yusendesu/gowin_fpga_inverted_pendulum/GoWin/figures/fig_2_4.png

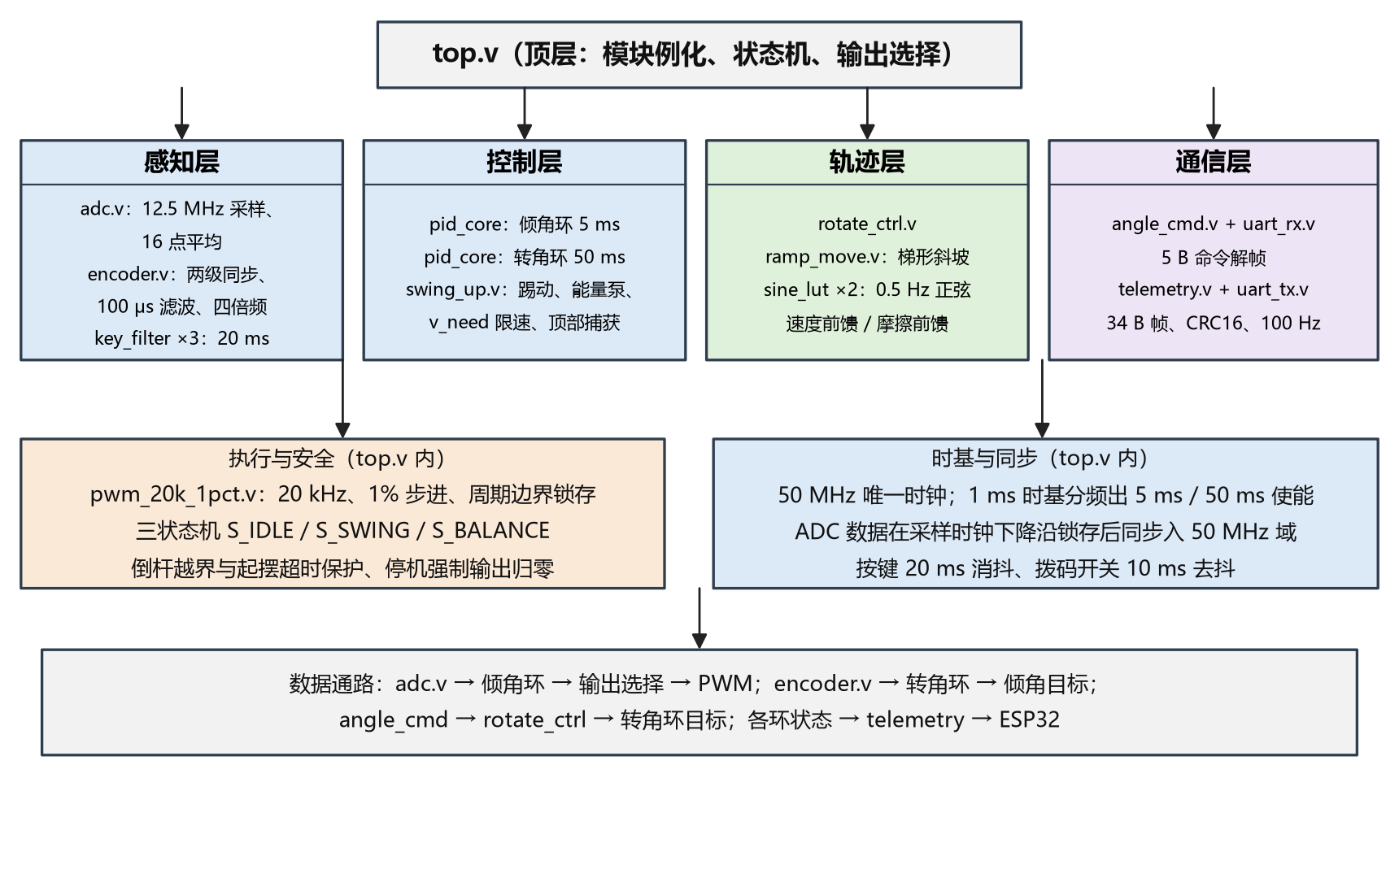
GoWin/figures/fig_2_4.png
