yusendesu/gowin_fpga_inverted_pendulum/GoWin/figures/fig_2_7.png

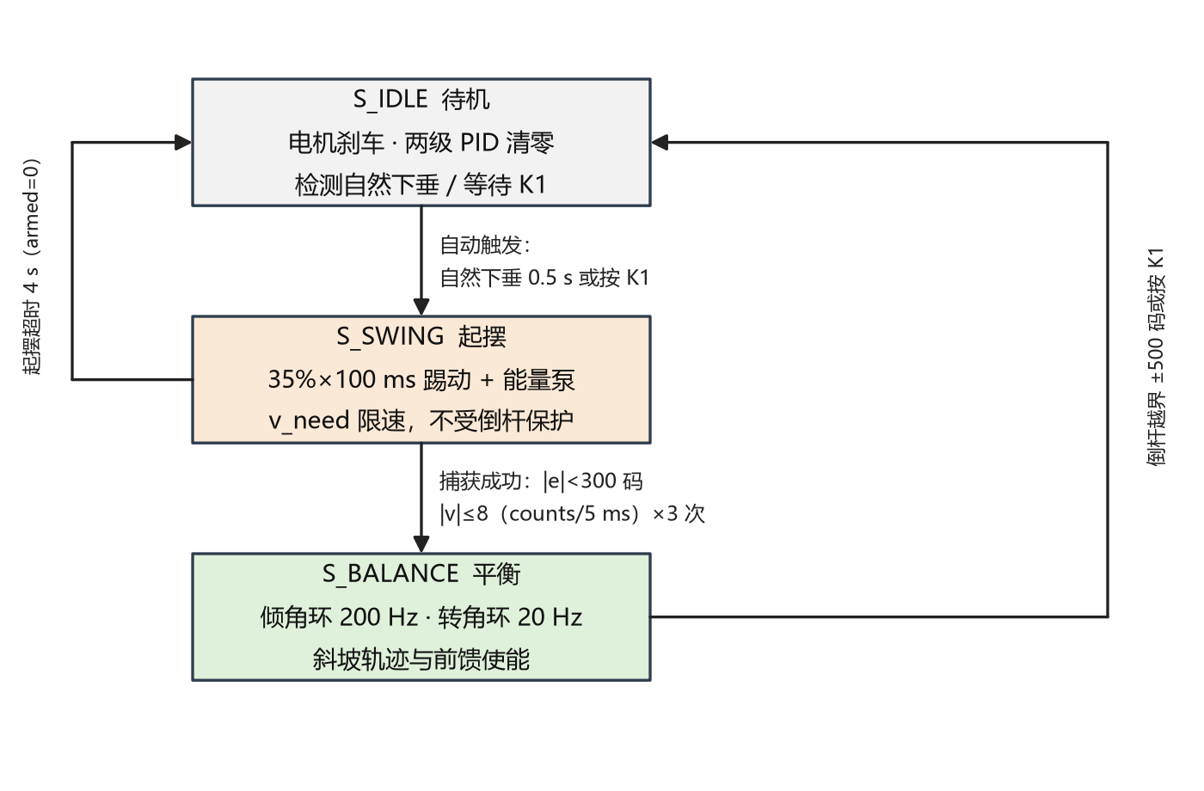
GoWin/figures/fig_2_7.png
