yusendesu/gowin_fpga_inverted_pendulum/GoWin/figures/hardware.png

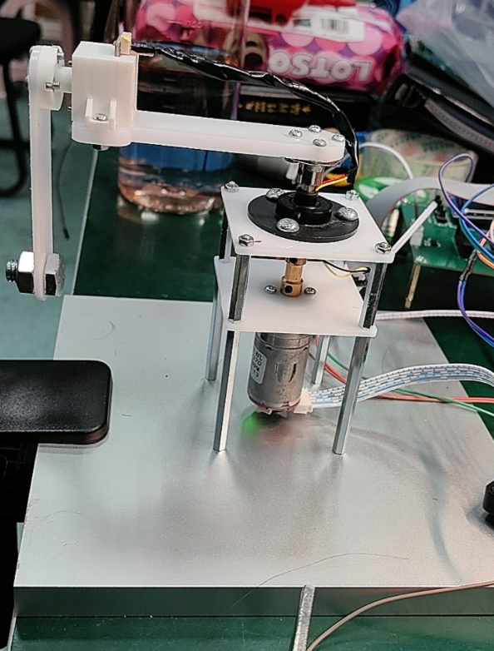
GoWin/figures/hardware.png
