yusendesu/gowin_fpga_inverted_pendulum/GoWin/figures/ui_gauge.png

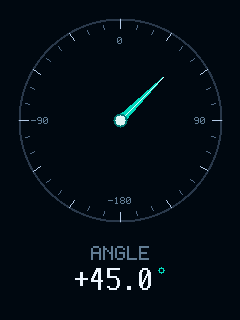
GoWin/figures/ui_gauge.png
