yusendesu/gowin_fpga_inverted_pendulum/GoWin/figures/ui_setting.png

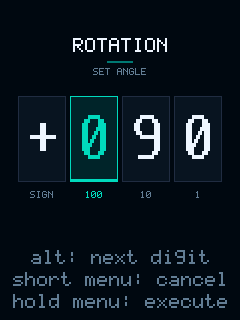
GoWin/figures/ui_setting.png
