yusendesu/gowin_fpga_inverted_pendulum/GoWin/sim/swing/model.png

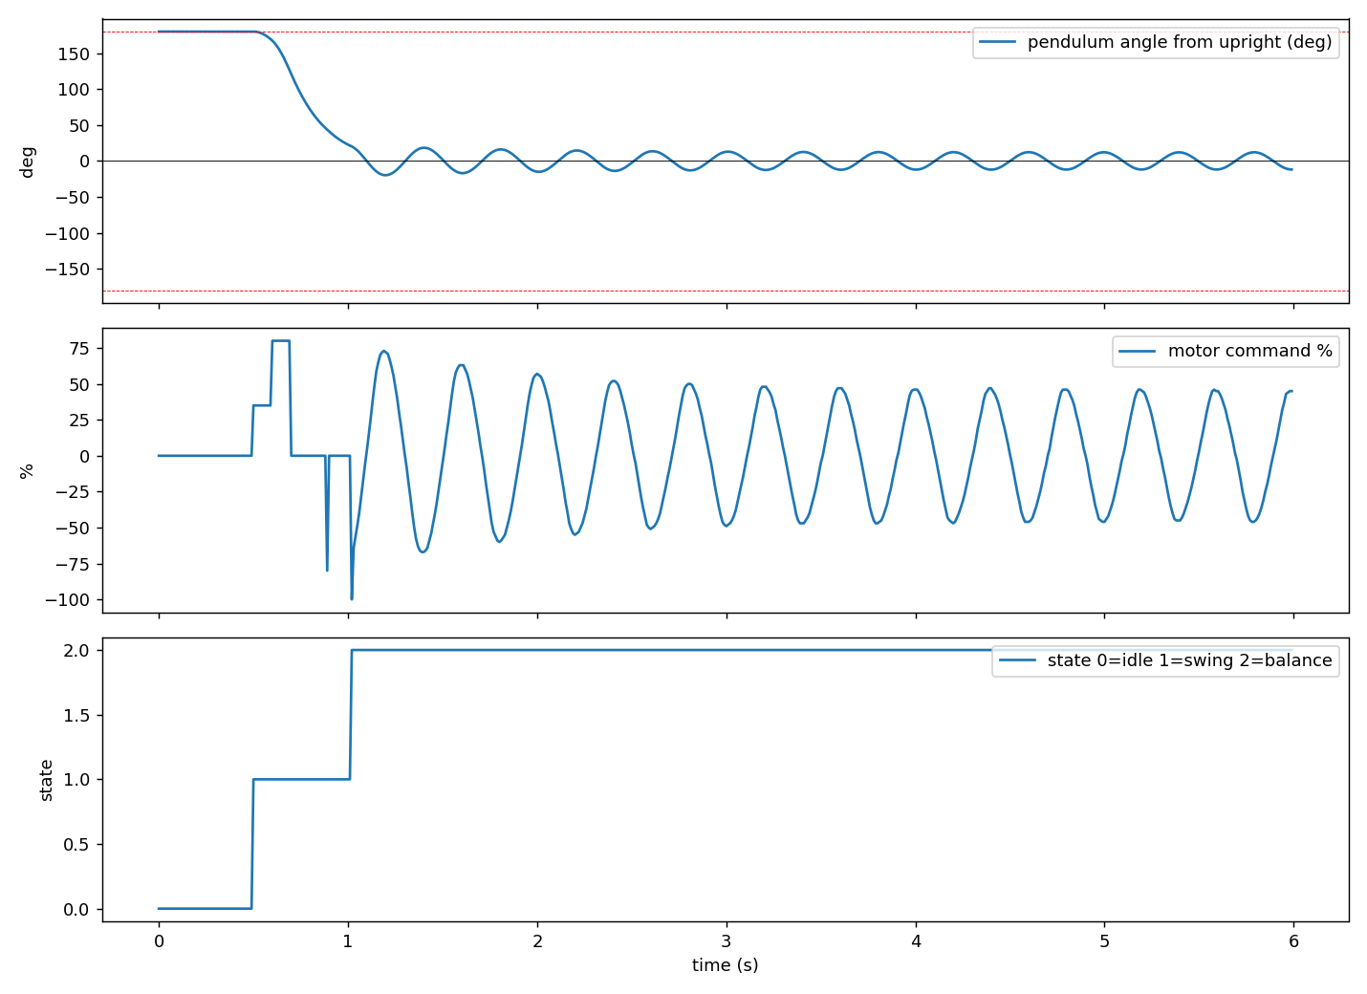
GoWin/sim/swing/model.png
