yusendesu/gowin_fpga_inverted_pendulum/GoWin/sim/swing/run_analysis.png

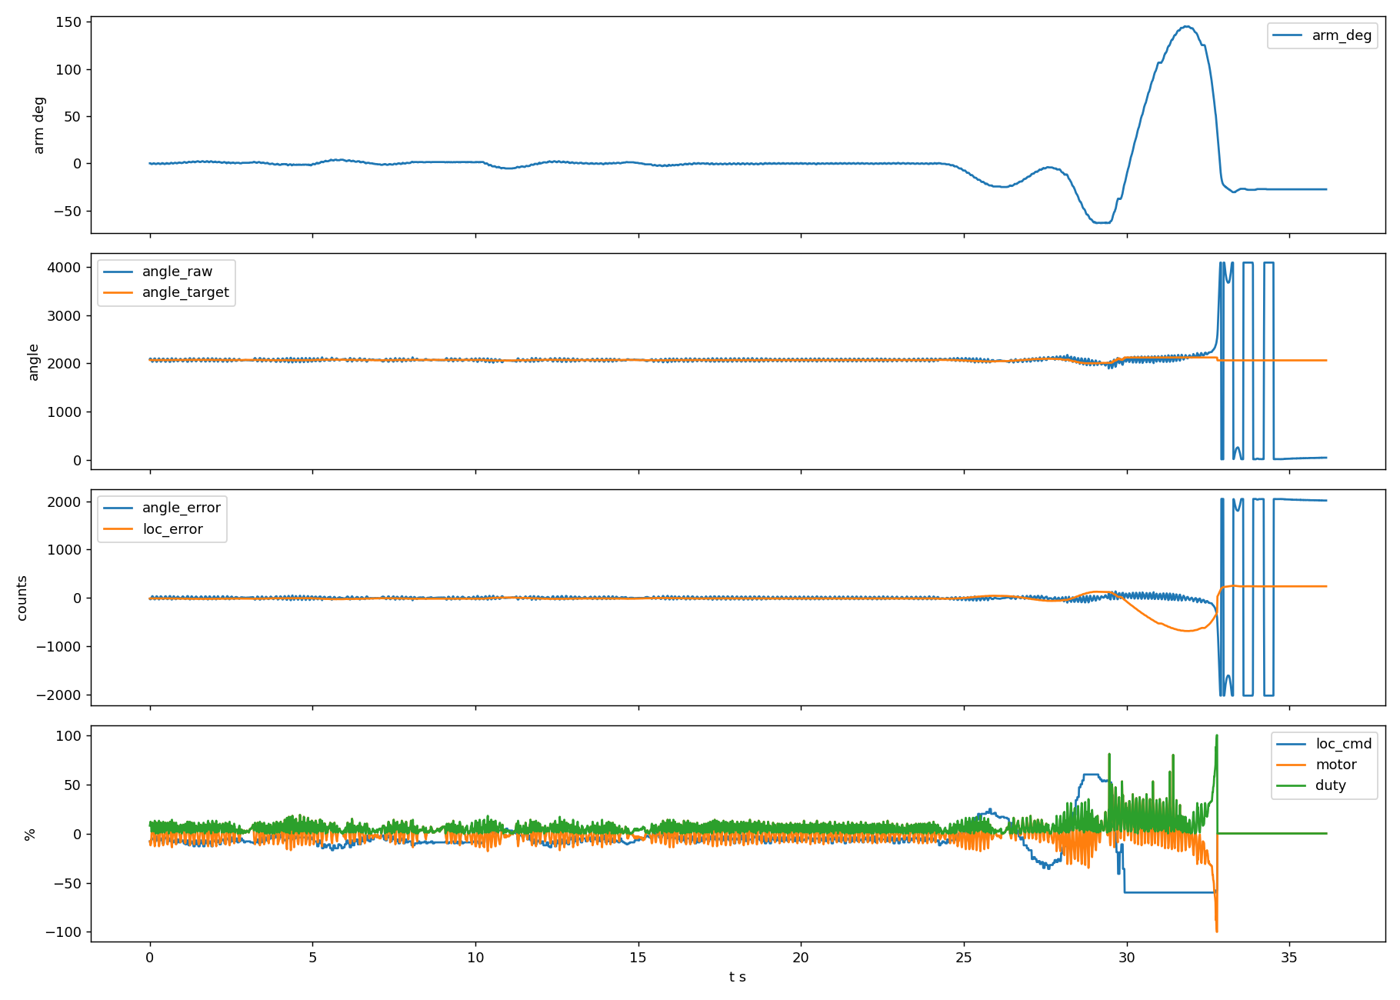
GoWin/sim/swing/run_analysis.png
