yusendesu/gowin_fpga_inverted_pendulum/v1_basic/key_filter_sim.jpg

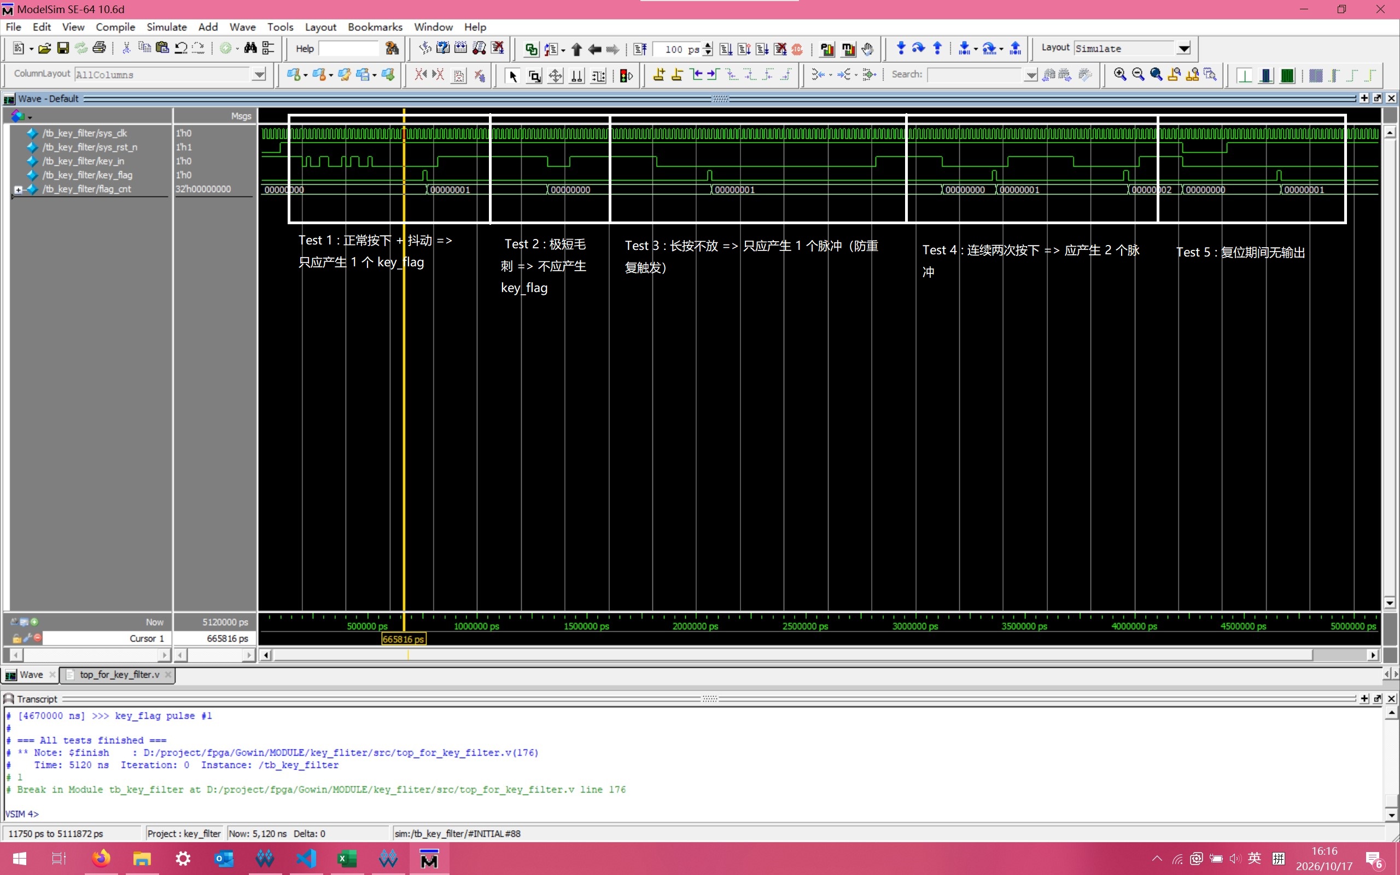
v1_basic/key_filter_sim.jpg
