yusendesu/gowin_fpga_inverted_pendulum/GoWin/src/sine_lut.v

// 256-entry sine LUT, sin(2*pi*i/256), Q15 signed
module sine_lut (
    input  wire [7:0] idx,
    output reg signed [15:0] val
);
    always @* begin
        case (idx)
        8'd0: val = 16'sd0;
        8'd1: val = 16'sd804;
        8'd2: val = 16'sd1608;
        8'd3: val = 16'sd2410;
        8'd4: val = 16'sd3212;
        8'd5: val = 16'sd4011;
        8'd6: val = 16'sd4808;
        8'd7: val = 16'sd5602;
        8'd8: val = 16'sd6393;
        8'd9: val = 16'sd7179;
        8'd10: val = 16'sd7962;
        8'd11: val = 16'sd8739;
        8'd12: val = 16'sd9512;
        8'd13: val = 16'sd10278;
        8'd14: val = 16'sd11039;
        8'd15: val = 16'sd11793;
        8'd16: val = 16'sd12539;
        8'd17: val = 16'sd13279;
        8'd18: val = 16'sd14010;
        8'd19: val = 16'sd14732;
        8'd20: val = 16'sd15446;
        8'd21: val = 16'sd16151;
        8'd22: val = 16'sd16846;
        8'd23: val = 16'sd17530;
        8'd24: val = 16'sd18204;
        8'd25: val = 16'sd18868;
        8'd26: val = 16'sd19519;
        8'd27: val = 16'sd20159;
        8'd28: val = 16'sd20787;
        8'd29: val = 16'sd21403;
        8'd30: val = 16'sd22005;
        8'd31: val = 16'sd22594;
        8'd32: val = 16'sd23170;
        8'd33: val = 16'sd23731;
        8'd34: val = 16'sd24279;
        8'd35: val = 16'sd24811;
        8'd36: val = 16'sd25329;
        8'd37: val = 16'sd25832;
        8'd38: val = 16'sd26319;
        8'd39: val = 16'sd26790;
        8'd40: val = 16'sd27245;
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
        8'd249: val = -16'sd5602;
        8'd250: val = -16'sd4808;
        8'd251: val = -16'sd4011;
        8'd252: val = -16'sd3212;
        8'd253: val = -16'sd2410;
        8'd254: val = -16'sd1608;
        8'd255: val = -16'sd804;
        endcase
    end
endmodule
