yusendesu/gowin_fpga_inverted_pendulum/exp32/vga1_16x32.py

WIDTH = 16
HEIGHT = 32
FIRST = 0x20
LAST = 0x7f
_FONT = \
b'\x00\x00\x00\x00\x00\x00\x00\x00\x00\x00\x00\x00\x00\x00\x00\x00\x00\x00\x00\x00\x00\x00\x00\x00\x00\x00\x00\x00\x00\x00\x00\x00\x00\x00\x00\x00\x00\x00\x00\x00\x00\x00\x00\x00\x00\x00\x00\x00\x00\x00\x00\x00\x00\x00\x00\x00\x00\x00\x00\x00\x00\x00\x00\x00'\
b'\x00\x00\x00\x00\x00\x00\x00\x00\x01\xc0\x01\xc0\x01\xc0\x01\xc0\x01\xc0\x01\xc0\x01\xc0\x01\xc0\x01\xc0\x01\xc0\x01\xc0\x01\xc0\x01\xc0\x01\xc0\x01\xc0\x01\xc0\x00\x00\x00\x00\x01\xc0\x01\xc0\x01\xc0\x01\xc0\x00\x00\x00\x00\x00\x00\x00\x00\x00\x00\x00\x00'\
b'\x00\x00\x00\x00\x1c\x38\x1c\x38\x1c\x38\x1c\x38\x1c\x38\x1c\x38\x1c\x38\x1c\x38\x00\x00\x00\x00\x00\x00\x00\x00\x00\x00\x00\x00\x00\x00\x00\x00\x00\x00\x00\x00\x00\x00\x00\x00\x00\x00\x00\x00\x00\x00\x00\x00\x00\x00\x00\x00\x00\x00\x00\x00\x00\x00\x00\x00'\
b'\x00\x00\x00\x00\x00\x00\x00\x00\x00\x00\x00\x00\x1c\x38\x1c\x38\x1c\x38\x1c\x38\x7f\xfe\x7f\xfe\x1c\x38\x1c\x38\x1c\x38\x1c\x38\x1c\x38\x1c\x38\x1c\x38\x1c\x38\x7f\xfe\x7f\xfe\x1c\x38\x1c\x38\x1c\x38\x1c\x38\x00\x00\x00\x00\x00\x00\x00\x00\x00\x00\x00\x00'\
b'\x00\x00\x00\x00\x01\x80\x01\x80\x0f\xf0\x0f\xf0\x39\x9c\x39\x9c\x71\x8e\x71\x8e\x71\x80\x71\x80\x39\x80\x39\x80\x0f\xf0\x0f\xf0\x01\x9c\x01\x9c\x01\x8e\x01\x8e\x71\x8e\x71\x8e\x39\x9c\x39\x9c\x0f\xf0\x0f\xf0\x01\x80\x01\x80\x00\x00\x00\x00\x00\x00\x00\x00'\
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
b'\x00\x00\x00\x00\x00\x00\x00\x00\x00\x00\x00\x00\x00\x00\x00\x00\x00\x00\x00\x00\x00\x00\x00\x00\x38\x0e\x38\x0e\x38\x0e\x38\x0e\x38\x0e\x38\x0e\x39\xce\x39\xce\x3b\xee\x3b\xee\x1f\x7c\x1f\x7c\x0e\x38\x0e\x38\x00\x00\x00\x00\x00\x00\x00\x00\x00\x00\x00\x00'\
b'\x00\x00\x00\x00\x00\x00\x00\x00\x00\x00\x00\x00\x00\x00\x00\x00\x00\x00\x00\x00\x00\x00\x00\x00\x1c\x38\x1c\x38\x0e\x70\x0e\x70\x07\xe0\x07\xe0\x03\xc0\x03\xc0\x07\xe0\x07\xe0\x0e\x70\x0e\x70\x1c\x38\x1c\x38\x00\x00\x00\x00\x00\x00\x00\x00\x00\x00\x00\x00'\
b'\x00\x00\x00\x00\x00\x00\x00\x00\x00\x00\x00\x00\x00\x00\x00\x00\x00\x00\x00\x00\x00\x00\x00\x00\x38\x0e\x38\x0e\x1c\x1c\x1c\x1c\x0e\x38\x0e\x38\x07\x70\x07\x70\x03\xe0\x03\xe0\x01\xc0\x01\xc0\x03\x80\x03\x80\x07\x00\x07\x00\x0e\x00\x0e\x00\x00\x00\x00\x00'\
b'\x00\x00\x00\x00\x00\x00\x00\x00\x00\x00\x00\x00\x00\x00\x00\x00\x00\x00\x00\x00\x00\x00\x00\x00\x3f\xfe\x3f\xfe\x00\x1c\x00\x1c\x00\x70\x00\x70\x01\xc0\x01\xc0\x07\x00\x07\x00\x1c\x00\x1c\x00\x3f\xfe\x3f\xfe\x00\x00\x00\x00\x00\x00\x00\x00\x00\x00\x00\x00'\
b'\x00\x00\x00\x00\x00\x00\x00\x00\x00\xf8\x00\xf8\x01\xc0\x01\xc0\x03\x80\x03\x80\x03\x80\x03\x80\x03\x80\x03\x80\x1e\x00\x1e\x00\x03\x80\x03\x80\x03\x80\x03\x80\x03\x80\x03\x80\x01\xc0\x01\xc0\x00\xf8\x00\xf8\x00\x00\x00\x00\x00\x00\x00\x00\x00\x00\x00\x00'\
b'\x00\x00\x00\x00\x00\x00\x00\x00\x01\xc0\x01\xc0\x01\xc0\x01\xc0\x01\xc0\x01\xc0\x01\xc0\x01\xc0\x01\xc0\x01\xc0\x00\x00\x00\x00\x01\xc0\x01\xc0\x01\xc0\x01\xc0\x01\xc0\x01\xc0\x01\xc0\x01\xc0\x01\xc0\x01\xc0\x00\x00\x00\x00\x00\x00\x00\x00\x00\x00\x00\x00'\
b'\x00\x00\x00\x00\x00\x00\x00\x00\x1f\x00\x1f\x00\x03\x80\x03\x80\x01\xc0\x01\xc0\x01\xc0\x01\xc0\x01\xc0\x01\xc0\x00\x78\x00\x78\x01\xc0\x01\xc0\x01\xc0\x01\xc0\x01\xc0\x01\xc0\x03\x80\x03\x80\x1f\x00\x1f\x00\x00\x00\x00\x00\x00\x00\x00\x00\x00\x00\x00\x00'\
b'\x00\x00\x00\x00\x00\x00\x00\x00\x07\x9e\x07\x9e\x3c\xf0\x3c\xf0\x00\x00\x00\x00\x00\x00\x00\x00\x00\x00\x00\x00\x00\x00\x00\x00\x00\x00\x00\x00\x00\x00\x00\x00\x00\x00\x00\x00\x00\x00\x00\x00\x00\x00\x00\x00\x00\x00\x00\x00\x00\x00\x00\x00\x00\x00\x00\x00'\
b'\x00\x00\x00\x00\x00\x00\x00\x00\x00\x00\x00\x00\x00\x00\x00\x00\x01\xc0\x01\xc0\x07\x70\x07\x70\x1c\x1c\x1c\x1c\x70\x07\x70\x07\x70\x07\x70\x07\x7f\xff\x7f\xff\x00\x00\x00\x00\x00\x00\x00\x00\x00\x00\x00\x00\x00\x00\x00\x00\x00\x00\x00\x00\x00\x00\x00\x00'\
 
FONT = memoryview(_FONT)
 
 
