yusendesu/gowin_fpga_inverted_pendulum/GoWin/src/uart_tx.v

module  uart_tx #(

    parameter   UART_BPS    =   'd9600,			//串口波特率
    parameter   CLK_FREQ    =   'd50_000_000	//时钟频率
	
) (

     input   	            sys_clk     ,	//系统时钟50MHz
     input   	            sys_rst_n   ,	//全局复位
	 
     input			[7:0]	pi_data     ,	//模块输入的8bit数据
     input					pi_flag     ,	//并行数据有效标志信号
 
     output		reg			tx			,	//串转并后的1bit数据
     output		reg	            pi_done			//发送完成一个字节标志（停止位结束）
	 
);

localparam  BAUD_CNT_MAX    =   CLK_FREQ/UART_BPS   ;

//reg   define
reg [12:0]  baud_cnt;
reg         bit_flag;
reg [3:0]   bit_cnt ;
reg         work_en ;


//work_en:接收数据工作使能信号
always@(posedge sys_clk or negedge sys_rst_n)
        if(sys_rst_n == 1'b0)
            work_en <= 1'b0;
        else    if(pi_flag == 1'b1)
            work_en <= 1'b1;
        else    if((bit_flag == 1'b1) && (bit_cnt == 4'd9))
            work_en <= 1'b0;

//baud_cnt:波特率计数器计数，从0计数到BAUD_CNT_MAX - 1
always@(posedge sys_clk or negedge sys_rst_n)
        if(sys_rst_n == 1'b0)
            baud_cnt <= 13'b0;
        else    if((baud_cnt == BAUD_CNT_MAX - 1) || (work_en == 1'b0))
            baud_cnt <= 13'b0;
        else    if(work_en == 1'b1)
            baud_cnt <= baud_cnt + 1'b1;

//bit_flag:当baud_cnt计数器计数到1时让bit_flag拉高一个时钟的高电平
always@(posedge sys_clk or negedge sys_rst_n)
        if(sys_rst_n == 1'b0)
            bit_flag <= 1'b0;
        else    if(baud_cnt == 13'd1)
            bit_flag <= 1'b1;
        else
            bit_flag <= 1'b0;

//bit_cnt:数据位数个数计数，10个有效数据（含起始位和停止位）到来后计数器清零
always@(posedge sys_clk or negedge sys_rst_n)
    if(sys_rst_n == 1'b0)
        bit_cnt <= 4'b0;
    else    if((bit_flag == 1'b1) && (bit_cnt == 4'd9))
        bit_cnt <= 4'b0;
    else    if((bit_flag == 1'b1) && (work_en == 1'b1))
        bit_cnt <= bit_cnt + 1'b1;

//tx:输出数据在满足rs232协议（起始位为0，停止位为1）的情况下一位一位输出
always@(posedge sys_clk or negedge sys_rst_n)
        if(sys_rst_n == 1'b0)
            tx <= 1'b1; //空闲状态时为高电平
        else    if(bit_flag == 1'b1)
            case(bit_cnt)
                0       : tx <= 1'b0;
                1       : tx <= pi_data[0];
                2       : tx <= pi_data[1];
                3       : tx <= pi_data[2];
                4       : tx <= pi_data[3];
                5       : tx <= pi_data[4];
                6       : tx <= pi_data[5];
                7       : tx <= pi_data[6];
                8       : tx <= pi_data[7];
                9       : tx <= 1'b1;
                default : tx <= 1'b1;
            endcase


reg         work_en_r1 ;
reg         work_en_r2 ;
always@(posedge sys_clk or negedge sys_rst_n)
        if(sys_rst_n == 1'b0)begin  
            work_en_r1 <= 1'b0;
            work_en_r2 <= 1'b0;
        end
        else begin
            work_en_r1 <= work_en;
            work_en_r2 <= work_en_r1;
        end

// pi_done: work_en 下降沿只代表“停止位开始”，必须再等一个完整位周期，
// 否则背靠背连发时停止位会被下一字节的起始位截短，接收端会把停止位
// 当成 bit7（0x55 被读成 0x95）。
reg         stop_wait;
reg  [12:0] stop_cnt;
always@(posedge sys_clk or negedge sys_rst_n)
        if(sys_rst_n == 1'b0)begin
            stop_wait <= 1'b0;
            stop_cnt  <= 13'd0;
            pi_done   <= 1'b0;
        end
        else begin
            pi_done <= 1'b0;
            if((work_en_r1 == 1'b0) && (work_en_r2 == 1'b1))begin
                stop_wait <= 1'b1;
                stop_cnt  <= 13'd0;
            end
            else if(stop_wait == 1'b1)begin
                if(stop_cnt == BAUD_CNT_MAX - 1)begin
                    stop_wait <= 1'b0;
                    pi_done   <= 1'b1;
                end
                else begin
                    stop_cnt <= stop_cnt + 1'b1;
                end
            end
        end

endmodule
