yusendesu/gowin_fpga_inverted_pendulum/GoWin/tools/build_report.py

# -*- coding: utf-8 -*-
"""按实际工程重建技术文档（保留原 docx 的样式、页面设置与页脚）。"""
import copy
import os
import re
import sys

from docx import Document
from docx.enum.table import WD_TABLE_ALIGNMENT
from docx.enum.text import WD_ALIGN_PARAGRAPH, WD_BREAK
from docx.oxml import OxmlElement
from docx.oxml.ns import qn
from docx.shared import Cm, Pt, RGBColor

HERE = os.path.dirname(os.path.abspath(__file__))
ROOT = os.path.dirname(HERE)
FIG = os.path.join(ROOT, "figures")

SRC = os.path.join(ROOT, "技术文档_底稿_基于FPGA的实时倒立摆姿态控制系统.docx")
DST = os.path.join(ROOT, "技术文档_基于FPGA的一阶旋转倒立摆实时姿态控制系统.docx")


# ---------------------------------------------------------------------------
# 基础排版工具
# ---------------------------------------------------------------------------

def clear_body(doc):
    body = doc.element.body
    for child in list(body):
        if child.tag == qn("w:sectPr"):
            continue
        body.remove(child)


def _set_run_font(run, size=None, bold=None, superscript=False):
    if size is not None:
        run.font.size = Pt(size)
    if bold is not None:
        run.font.bold = bold
    if superscript:
        run.font.superscript = True
    # 中英文分别指定，避免混排时回退到 Calibri
    rpr = run._element.get_or_add_rPr()
    rfonts = rpr.find(qn("w:rFonts"))
    if rfonts is None:
        rfonts = OxmlElement("w:rFonts")
        rpr.append(rfonts)
    rfonts.set(qn("w:ascii"), "Times New Roman")
    rfonts.set(qn("w:hAnsi"), "Times New Roman")
    rfonts.set(qn("w:eastAsia"), "宋体")


CITE_RE = re.compile(r"\[\[(\d+(?:,\s*\d+)*)\]\]")


def para(doc, text, style="Normal", align=None, size=None, bold=False,
         before=None, after=None, indent_chars=None, line=None, keep_next=False):
    p = doc.add_paragraph(style=style)
    if align is not None:
        p.alignment = align
    pf = p.paragraph_format
    if before is not None:
        pf.space_before = Pt(before)
    if after is not None:
        pf.space_after = Pt(after)
    if line is not None:
        pf.line_spacing = line
    if indent_chars:
        pf.first_line_indent = Pt(indent_chars * (size or 12))

    pos = 0
    for m in CITE_RE.finditer(text):
        head = text[pos:m.start()]
        if head:
            _set_run_font(p.add_run(head), size, bold)
        _set_run_font(p.add_run("[%s]" % m.group(1)), size, bold, superscript=True)
        pos = m.end()
    tail = text[pos:]
    if tail:
        _set_run_font(p.add_run(tail), size, bold)
    if keep_next:
        pf.keep_with_next = True
    return p


def h1(doc, text):
    p = doc.add_paragraph(style="Heading 1")
    _set_run_font(p.add_run(text), 14, True)
    return p


def h2(doc, text):
    p = doc.add_paragraph(style="Heading 2")
    _set_run_font(p.add_run(text), 12, True)
    return p


def h3(doc, text):
    p = doc.add_paragraph(style="Heading 3")
    _set_run_font(p.add_run(text), 12, True)
    return p


def caption(doc, text):
    p = doc.add_paragraph(style="Normal")
    p.alignment = WD_ALIGN_PARAGRAPH.CENTER
    p.paragraph_format.space_before = Pt(3)
    p.paragraph_format.space_after = Pt(12)
    p.paragraph_format.line_spacing = 1.0
    _set_run_font(p.add_run(text), 10.5, False)
    return p


def figure(doc, name, width_cm, title):
    p = doc.add_paragraph(style="Normal")
    p.alignment = WD_ALIGN_PARAGRAPH.CENTER
    p.paragraph_format.space_before = Pt(6)
    p.paragraph_format.space_after = Pt(0)
    p.paragraph_format.line_spacing = 1.0
    p.add_run().add_picture(os.path.join(FIG, name), width=Cm(width_cm))
    caption(doc, title)


def figure_pair(doc, names, width_cm, title):
    p = doc.add_paragraph(style="Normal")
    p.alignment = WD_ALIGN_PARAGRAPH.CENTER
    p.paragraph_format.space_before = Pt(6)
    p.paragraph_format.space_after = Pt(0)
    p.paragraph_format.line_spacing = 1.0
    for i, name in enumerate(names):
        if i:
            r = p.add_run("    ")
            _set_run_font(r, 10.5)
        p.add_run().add_picture(os.path.join(FIG, name), width=Cm(width_cm))
    caption(doc, title)


def _shade(cell, hex_color="F2F2F2"):
    tcPr = cell._tc.get_or_add_tcPr()
    shd = OxmlElement("w:shd")
    shd.set(qn("w:val"), "clear")
    shd.set(qn("w:color"), "auto")
    shd.set(qn("w:fill"), hex_color)
    tcPr.append(shd)


def _cell_text(cell, text, bold=False, size=10.5, align=WD_ALIGN_PARAGRAPH.CENTER):
    cell.text = ""
    p = cell.paragraphs[0]
    p.alignment = align
    p.paragraph_format.space_before = Pt(2)
    p.paragraph_format.space_after = Pt(2)
    p.paragraph_format.line_spacing = 1.0
    _set_run_font(p.add_run(text), size, bold)


def table(doc, headers, rows, widths, align_left_cols=(), font=10.5):
    t = doc.add_table(rows=1, cols=len(headers))
    t.style = "Table Grid"
    t.alignment = WD_TABLE_ALIGNMENT.CENTER
    t.autofit = False
    hdr = t.rows[0]
    trPr = hdr._tr.get_or_add_trPr()
    tblHeader = OxmlElement("w:tblHeader")
    trPr.append(tblHeader)
    for i, h in enumerate(headers):
        _cell_text(hdr.cells[i], h, True, font)
        _shade(hdr.cells[i])
        hdr.cells[i].width = Cm(widths[i])
    for row in rows:
        cells = t.add_row().cells
        for i, v in enumerate(row):
            al = WD_ALIGN_PARAGRAPH.LEFT if i in align_left_cols else WD_ALIGN_PARAGRAPH.CENTER
            _cell_text(cells[i], v, False, font, al)
            cells[i].width = Cm(widths[i])
    for i, w in enumerate(widths):
        for row in t.rows:
            row.cells[i].width = Cm(w)

    # 固定列宽：同时写 tblGrid、tblW 与 tblLayout，避免渲染器按内容重排
    total = sum(widths)
    tblPr = t._tbl.tblPr
    for tag in ("w:tblW", "w:tblLayout"):
        el = tblPr.find(qn(tag))
        if el is not None:
            tblPr.remove(el)
    tblW = OxmlElement("w:tblW")
    tblW.set(qn("w:type"), "dxa")
    tblW.set(qn("w:w"), str(int(total * 567)))
    tblPr.append(tblW)
    layout = OxmlElement("w:tblLayout")
    layout.set(qn("w:type"), "fixed")
    tblPr.append(layout)
    grid = t._tbl.tblGrid
    for col, w in zip(grid.gridCol_lst, widths):
        col.w = Cm(w)
    # 行不跨页拆开
    for row in t.rows:
        trPr = row._tr.get_or_add_trPr()
        cant = OxmlElement("w:cantSplit")
        trPr.append(cant)
    doc.add_paragraph(style="Normal").paragraph_format.space_after = Pt(2)
    return t


def log_block(doc, text):
    p = doc.add_paragraph(style="Normal")
    p.paragraph_format.left_indent = Cm(1.0)
    p.paragraph_format.space_before = Pt(3)
    p.paragraph_format.space_after = Pt(8)
    p.paragraph_format.line_spacing = 1.15
    r = p.add_run(text)
    r.font.size = Pt(9.5)
    rpr = r._element.get_or_add_rPr()
    rfonts = OxmlElement("w:rFonts")
    rfonts.set(qn("w:ascii"), "Consolas")
    rfonts.set(qn("w:hAnsi"), "Consolas")
    rfonts.set(qn("w:eastAsia"), "宋体")
    rpr.append(rfonts)
    return p


def page_break(doc):
    p = doc.add_paragraph(style="Normal")
    p.add_run().add_break(WD_BREAK.PAGE)


# ---------------------------------------------------------------------------
# 正文
# ---------------------------------------------------------------------------

def build():
    doc = Document(SRC)
    clear_body(doc)

    cp = doc.core_properties
    cp.title = "基于 FPGA 的一阶旋转倒立摆实时姿态控制系统"
    cp.subject = "项目技术文档"
    cp.author = "项目组"
    cp.last_modified_by = "项目组"
    cp.comments = "依据 Gowin GW2A-18 工程与 ESP32 MicroPython 工程整理"

    # ---------------- 封面标题 ----------------
    p = doc.add_paragraph(style="Normal")
    p.alignment = WD_ALIGN_PARAGRAPH.CENTER
    p.paragraph_format.space_before = Pt(18)
    p.paragraph_format.space_after = Pt(18)
    _set_run_font(p.add_run("基于 FPGA 的一阶旋转倒立摆实时姿态控制系统"), 18, True)

    p = doc.add_paragraph(style="Normal")
    p.alignment = WD_ALIGN_PARAGRAPH.CENTER
    p.paragraph_format.space_after = Pt(24)
    _set_run_font(p.add_run("——能量泵起摆、双速率串级平衡与角度定位的实现"), 12, False)

    # ---------------- 摘要 ----------------
    h2(doc, "摘  要")
    para(doc, (
        "本作品以高云 GW2A-LV18PG256CC8/I7（GW2A-18）FPGA 为唯一实时控制核心，实现了一阶旋转倒立摆"
        "（Furuta 摆）的自动起摆、长期直立与角度定位。整机只有三个外设：一台直流减速电机、一个增量式"
        "编码器和一个模数转换通道。电机经 30∶1 减速器驱动摆臂，编码器与电机尾轴同轴，四倍频后摆臂转一圈"
        "为 1320 个计数，用于测量摆臂转角 φ；摆杆铰接在摆臂末端，铰接轴同轴安装 WDD35D4 导电塑料电位器，"
        "其输出经 AD9200 10 bit 并行 ADC 以 12.5 MHz 采样，在 1 ms 窗口内等间隔抽取 16 点求平均后扩展为"
        "12 bit 倾角码值 θ。"
    ))
    para(doc, (
        "FPGA 片内以纯硬件逻辑实现全部实时回路：倾角内环 5 ms（200 Hz）、摆臂转角外环 50 ms（20 Hz），"
        "两级均采用 16.16 定点 PID；20 kHz、1% 步进的 PWM 由周期计数器在周期边界锁存占空比；采样、运算与"
        "输出同在 50 MHz 时钟域内，由同一组计数器严格分频，控制周期抖动为零个时钟周期，不受中断响应与"
        "任务调度影响。起摆采用“固定踢动—能量泵—v_need 限速—顶部捕获”四段式策略：摆杆自然下垂持续"
        "0.5 s 后自动触发一次起摆，能量泵按能量梯度方向注入机械能，v_need 查表保证摆杆“刚好到顶”而不"
        "越摆越快，进入捕获窗口并连续三个节拍满足角度与角速度条件后，无扰切入平衡控制。定位运动把轨迹"
        "生成与跟踪分离：梯形速度斜坡给出有界、可预测的转角目标，叠加速度前馈与摩擦前馈，并设置总行程、"
        "跟踪误差与移动时间三重保护，使“边走边稳”成为结构性保证而非调参结果；拨码开关还可启动 0.5 Hz、"
        "8° 的往复正弦摆动。"
    ))
    para(doc, (
        "人机交互由 ESP32（MicroPython）承担：240×320 ST7789 屏以指针表盘显示角度，4 个按键完成旋转角的"
        "符号与数值设定，长按即下发；ESP32 同时开启 Wi-Fi 与内置 HTTP 服务，手机连接热点后用网页即可下发"
        "角度，形成“屏 + 键 + 网页”三通道交互。FPGA 以 100 Hz 发送 34 字节遥测帧，带序号、毫秒时间戳与"
        "CRC-16 校验，回传角度、目标、编码器、两环输出、占空比与全部状态位。RTL 仿真表明：起摆 0.575 s "
        "进入捕获窗口，捕获时角度偏差 148 码、角速度 −8 counts/5 ms；+90° 定位在 3.366 s 内完成且无过冲；"
        "解帧、斜坡、PID 抗饱和等 9 组用例全部通过。样机联调完成了自动起摆、稳定直立与角度设定三项功能。"
    ))
    para(doc, (
        "在此基础上，系统把网络控制作为“监督层”引入，形成“实时环在片内、网络环在片外”的分层结构："
        "ESP32 网关向上提供 Wi-Fi 与 HTTP 接口，向下以 5 字节命令与 100 Hz 遥测同 FPGA 交互。网络延迟与"
        "丢包不进入 5 ms 内环，远程指令须经协议限幅、梯形斜坡与倾角限幅三级整形后才作用于机构，因此"
        "断链时装置仍能本地保持平衡。该结构既满足工业现场远程遥操作与集中监控的需要，也为强化学习等"
        "AI 策略预留了数据采集与策略回灌通道，使算法迭代可以在不影响装置安全的前提下进行。"
    ))
    para(doc, "关键词：FPGA；旋转倒立摆；串级 PID；能量泵起摆；网络化控制；边缘网关；ESP32", bold=False)

    # =====================================================================
    h1(doc, "第一部分  作品概述")

    h2(doc, "1.1 功能与特性")
    para(doc, "系统面向一阶旋转倒立摆，覆盖基础要求与拓展要求，主要功能如下。")
    para(doc, (
        "（1）自动起摆与无扰切换。摆杆自然下垂（角度码值落在 0 或 4095 附近 ±480 码内）持续 0.5 s 后，"
        "状态机自动进入起摆：先给 35% 占空比、100 ms 的定向踢动打破静止死点，随后由能量泵按 "
        "u = sign(v·cos e) 注入机械能；当摆杆进入以平衡点为中心 ±300 码（约 ±25°）的窗口、且角速度"
        "绝对值不超过 8 counts/5 ms 并连续保持 3 个 5 ms 节拍时判定捕获成功，立即切换到平衡控制。"
        "切换瞬间外环目标锁存为当前摆臂转角，两环 PID 历史清零，控制量连续、无冲击。"
    ))
    para(doc, (
        "（2）自平衡与倒杆保护。以 5 ms 周期采集摆杆倾角，经倾角环 PID 得到带符号的 PWM 指令，再经"
        "20 kHz、1% 步进的 PWM 驱动电机，使摆杆长时间保持直立。平衡状态下若倾角相对平衡点偏离超过"
        "±500 码（约 ±42°），状态机立即回到待机、封锁电机输出并撤销自动触发，避免电机堵转与机构损坏。"
    ))
    para(doc, (
        "（3）抗扰恢复。平衡状态下承受轻度侧向推力后，倾角环在数十毫秒内给出反向加速度，外环把摆臂"
        "带回原转角，系统在有限时间内回到平衡点，无持续等幅振荡。"
    ))
    para(doc, (
        "（4）角度定位。ESP32 或手机网页下发一帧目标角度后，梯形速度斜坡生成“加速—匀速—按剩余距离"
        "减速—末端吸附”的转角目标，位置环跟踪该目标，同时叠加速度前馈与摩擦前馈；运动全程摆杆保持"
        "直立，实现“边走边稳”。运动中收到的新命令累加到当前目标而不打断速度曲线；一次连续移动的总行程、"
        "跟踪误差与移动时间均设上限，任何一项越限即放弃本次移动并置故障位。"
    ))
    para(doc, (
        "（5）正弦摆动。拨码开关 C8 拨到 ON 后，系统在平衡中心附近按 0.5 Hz、8° 的幅度做往复正弦摆动，"
        "增益在约 1 s 内渐入渐出，避免起步与停止冲击；摆动期间速度前馈同步输出，相位与幅值由 256 点"
        "正弦表保证。"
    ))
    para(doc, (
        "（6）状态监视与三通道交互。FPGA 以 100 Hz 发送 34 字节遥测帧（含序号、时间戳、CRC-16），"
        "ESP32 解析后驱动指针表盘，同时把当前 IP 常驻显示在屏幕底部；4 个按键可完成符号/百位/十位/个位"
        "的设定与下发；手机连接热点后通过网页按钮下发角度。三条通道都只改变“目标与模式”，不参与实时闭环。"
    ))
    para(doc, (
        "（7）网络化远程监控与遥操作。ESP32 网关通过 Wi-Fi 提供网页与 HTTP 接口，可远程完成目标角度下发、"
        "图形化监视与状态巡检，并用同一套接口向 MQTT/云平台转发数据。网络只作用于“目标层”：链路中断时"
        "保持当前目标、本地闭环继续运行；恢复后无需重启即可继续接受指令。这一功能面向真实工业场景——"
        "操作者远离设备、多台装置集中监控、以及把运行数据交给上位机或算法做分析。"
    ))

    h2(doc, "1.2 应用领域")
    para(doc, (
        "旋转倒立摆是控制领域最典型的欠驱动、非线性、开环不稳定系统：只有一个执行器，却要同时稳定"
        "摆臂转角与摆杆倾角两个自由度，且摆杆通道存在右半平面极点。这种“用有限执行器同时稳定多个自由度”"
        "的问题结构，与起重机的防摆控制、平衡车与两轮机器人、火箭垂直回收的姿态稳定、机械臂末端残余"
        "振动抑制等工程对象同构。本作品所采用的“快内环 + 慢外环 + 轨迹前馈 + 硬件确定性节拍”技术路线，"
        "可以直接迁移到上述场景；而全部控制律以定点运算在 FPGA 内并行实现的方式，也适用于对控制周期"
        "抖动敏感的伺服与电力电子装置。"
    ))

    h2(doc, "1.3 主要技术特点")
    para(doc, (
        "（1）单芯片全硬件闭环。角度采样与平均、编码器解码、双环 PID、PWM 生成、串口收发全部由 FPGA "
        "内部逻辑实现，控制节拍由 50 MHz 计数器严格分频得到（1 ms 时基再分频出 5 ms 与 50 ms 使能），"
        "周期抖动为零个时钟周期，不受中断响应、任务调度与通信抖动影响。"
    ))
    para(doc, (
        "（2）双速率串级与带宽分离。倾角环 5 ms、转角环 50 ms，两者周期相差整十倍，天然形成约一个"
        "数量级的带宽分离：内环负责“别倒”，外环负责“去哪”。外环输出不是直接的控制量，而是倾角指令"
        "相对平衡点的偏移，并被限幅在 ±60 码（约 ±5°）以内，因此无论目标阶跃多大，摆杆倾角都不会"
        "被要求做出超过 5° 的响应，摆臂加速度随之被约束在机构可承受的范围内。"
    ))
    para(doc, (
        "（3）面向噪声的反馈链设计。ADC 在 12.5 MHz 采样时钟的下降沿锁存数据以避开变化沿，再经寄存器"
        "同步进入 50 MHz 域；1 ms 内 16 点平均使白噪声标准差降为 1/4，等效信噪比改善约 12 dB，代价是"
        "约 0.5 ms 的群延迟。编码器通道采用“电平连续 100 μs 不变才确认跳变”的稳定时间滤波：100 μs "
        "对应可跟踪约 2727°/s，而若沿用 1 ms 则只能跟踪约 273°/s，快速摆动时会出现“计数不更新”。"
    ))
    para(doc, (
        "（4）定点 PID 的数值安全。两级 PID 均为 16.16 定点位置式结构，D 项对“测量值”而非误差微分，"
        "目标阶跃不会产生微分冲击；积分项带对称限幅（倾角环 500 码、转角环 1000 码），输出饱和且误差"
        "同向时停止积分；启动沿预置上一拍测量值，停机时彻底清零。这些措施把“积分溢出回绕导致满占空比”"
        "这类数值故障从结构上排除。"
    ))
    para(doc, (
        "（5）能量泵起摆的“刚好到顶”。只在 |v| 小于 v_need(e) 时继续泵能量，v_need 由摆长与重力按"
        "能量守恒预先算成 33 项查表，因而摆杆能量接近“刚好到顶”时自动停止注入，顶部速度被限制在"
        "可捕获范围内，不会越摆越快直至整周旋转。"
    ))
    para(doc, (
        "（6）轨迹生成与跟踪分离。定位不再由“位置误差 → PD → 倾角”直接生成轨迹，而由独立的梯形斜坡"
        "发生器给出有界、可预测的位置目标，PID 只负责跟踪；配合速度前馈、摩擦前馈与三重保护，从结构上"
        "消除了旧版“连续发帧把轨迹反复打断、越转越快”的问题。"
    ))
    para(doc, (
        "（7）网络与控制的分层解耦。控制节拍由片内计数器产生，网络只写目标寄存器，不参与任何一次采样或"
        "运算；远程指令依次经过协议限幅（±180°）、梯形斜坡（27°/s、1000 counts/s²）与倾角限幅（±60 码）"
        "三级整形，任何网络侧异常都被限制在“目标变化率”这一层，不会破坏内环的确定性。"
    ))

    h2(doc, "1.4 主要性能指标")
    para(doc, "系统主要性能指标见表 1-1。表中“设计值”由架构与参数确定，“验证结果”来自 RTL 仿真、"
              "综合报告或样机联调，未标注的整机量化指标仍需在标准测试条件下复测。")
    caption(doc, "表 1-1  系统主要性能指标")
    table(doc, ["项目", "设计值 / 规格", "验证结果"], [
        ["主控平台", "GW2A-18，50 MHz 单时钟域", "综合通过，LUT 3245"],
        ["控制周期", "倾角环 5 ms（200 Hz）、转角环 50 ms（20 Hz）", "零周期抖动"],
        ["角度采样", "12.5 MHz 采样，1 ms 内 16 点平均，输出 12 bit", "仿真通过"],
        ["角度分辨率", "0.084°/码（345° 行程对应 4096 码）", "按器件手册折算"],
        ["编码器", "11 线四倍频，1320 counts/摆臂圈，0.273°/count", "仿真通过"],
        ["PWM", "20 kHz，1% 步进（0~100）", "仿真通过"],
        ["起摆", "下垂 0.5 s 自动触发，单次超时 4 s", "0.575 s 捕获（RTL）"],
        ["平衡保持", "持续运行，±500 码（约 ±42°）倒杆保护", "样机联调通过"],
        ["角度环参数", "Kp 0.30 / Ki 0.01 / Kd 0.40（5 ms）", "整定值"],
        ["转角环参数", "Kp 0.40 / Ki 0 / Kd 1.50（50 ms）", "整定值"],
        ["定位", "最大 27°/s、1000 counts/s²，±180° 单帧", "+90° 用时 3.366 s"],
        ["通信", "115200 8N1；遥测 34 B @100 Hz；命令 5 B", "仿真通过"],
        ["资源占用", "LUT 3245、FF 971、DSP 17.25/24、CLS 24%", "布局布线报告"],
    ], [3.6, 7.6, 3.6], align_left_cols=())

    h2(doc, "1.5 主要创新点")
    para(doc, (
        "（1）v_need 限速的能量泵起摆。把“摆杆升到竖直所需的最小速度”预先算成随角度变化的查表，"
        "仅当实际角速度小于该门限时才注入能量，使起摆过程自动收敛到“刚好到顶”，避免了定占空比"
        "泵能量必然导致的越摆越快与整周旋转。"
    ))
    para(doc, (
        "（2）加速度约束前移到指令层。外环输出即倾角指令偏移并限幅 ±60 码，位置阶跃自动变成受限的"
        "加减速过程，无需额外轨迹规划即可保证“移动中不倒”；配合梯形斜坡后，轨迹形状与跟踪精度解耦，"
        "两者可以独立整定。"
    ))
    para(doc, (
        "（3）双速率串级 + 定点数值安全的工程化实现。5 ms / 50 ms 两级节拍由同一计数器分频得到，"
        "绝对相位关系固定；PID 的积分限幅、条件积分、对测量微分、运动期清积分共同构成一套可复用的"
        "定点控制器模板。"
    ))
    para(doc, (
        "（4）低成本反馈链。用 10 bit 并行 ADC 加 1 ms 多点平均获得 12 bit 有效码值，用 100 μs 稳定"
        "时间滤波兼顾抗噪与高速跟踪，使普通器件也能满足倒立摆的反馈精度要求。"
    ))
    para(doc, (
        "（5）三通道交互与实时回路的彻底解耦。屏幕、按键、网页都工作在毫秒级的“慢环”，只读写目标与"
        "模式；控制回路完全在片内，即使 ESP32 重启或掉线，平衡状态也不受影响。"
    ))
    para(doc, (
        "（6）面向工业遥操作的网络化控制架构。把“网络”当监督层而不是控制通路：网络只写目标、不写节拍；"
        "上行 100 Hz 遥测带序号与毫秒时标，使链路时延、丢帧与抖动可以被量化；下行指令经三级整形，把"
        "网络的最坏情况（延迟、乱序、误操作）约束为“目标变化率过大”这一种可控故障。对真实工业场景而言，"
        "这比“把控制器搬上云”更有价值：远程可以设定、可以看、可以停，但装置的安全始终由现场环路保证。"
    ))
    para(doc, (
        "（7）面向 AI 的开放数据与控制接口。同一套遥测与命令通道既服务于人，也服务于算法：100 Hz 同步"
        "采样可直接构成（状态，动作，下一状态）序列用于离线训练，训练出的策略又能以参考轨迹、前馈补偿"
        "或增益组的形式回灌到现有控制结构；配合“影子模式 + 安全包络”，学习型控制可以在不牺牲安全性的"
        "前提下逐步上线，也可以随时回退到 PID。"
    ))

    h2(doc, "1.6 设计流程")
    para(doc, (
        "设计流程为：需求分析 → 被控对象建模与参数辨识 → 总体架构与接口划分 → 分模块 RTL 编写 → "
        "iverilog 单元仿真 → 闭环模型与 top 级仿真 → 单模块板级验证（ADC 码值、编码器计数、UART 收发、"
        "PWM 波形）→ 倾角环整定 → 转角环整定 → 起摆状态机联调 → 轨迹与定位联调 → ESP32 交互联调 → "
        "功能与性能测试 → 文档整理。"
    ))
    para(doc, (
        "其中“先建模、再仿真、后上板”是缩短调试周期的关键。摆杆模型先用 Python 闭环验证起摆律与捕获"
        "窗口（sim/swing/model.py），再把同一控制律写成 RTL，用 1 MHz 时钟的模块级测试平台复现；确认"
        "算法正确后，才在 50 MHz 的完整 top 上验证时序与状态迁移。这样每一层只引入一个新变量，出现"
        "问题时可以快速定位到“算法、实现、时序、硬件”中的哪一层。"
    ))

    # =====================================================================
    h1(doc, "第二部分  系统组成及功能说明")

    h2(doc, "2.1 整体介绍")
    para(doc, (
        "系统按“感知—控制—执行—交互”四层组织，总体框图如图 2-1 所示。感知层只有两路反馈：摆杆倾角"
        "通道由 WDD35D4 电位器与 AD9200 构成，摆臂转角通道由与电机尾轴同轴的增量式编码器构成。控制层"
        "以 GW2A-18 为核心，片内包含角度采集与平均、编码器解码、双环 PID、起摆与安全状态机、梯形斜坡"
        "与正弦轨迹、命令解帧与遥测组帧等功能单元。执行层由 TB6612FNG 单路 H 桥与直流减速电机构成，"
        "接收 FPGA 输出的方向电平与 20 kHz PWM。交互层由 ESP32、240×320 TFT 屏、4 个按键与 Wi-Fi "
        "网页构成，通过 115200 bps 串口与 FPGA 通信。"
    ))
    figure(doc, "fig_2_1.png", 14.6, "图 2-1  系统总体框图")
    para(doc, (
        "四层之间的耦合关系是：控制层以 5 ms 的固定节拍读取倾角、以 50 ms 的固定节拍读取转角，在同一"
        "节拍内完成运算并更新输出；交互层以远低于控制频率的节拍旁路接入，只改变模式、目标与校准量，"
        "不参与实时闭环。这种“快环在片内、慢环在片外”的分工，使控制回路的时序完全由硬件逻辑决定："
        "交互侧的刷屏、网页请求、Wi-Fi 重连即使卡顿上百毫秒，也不会传导到控制回路。"
    ))

    h2(doc, "2.2 硬件系统介绍")
    h3(doc, "2.2.1 硬件整体介绍")
    para(doc, (
        "整机以 GW2A-18 开发板为主控板，板上 50 MHz 有源晶振经全局时钟网络驱动全部同步逻辑；传感器与"
        "驱动器通过板载扩展口与 FPGA 的通用 I/O 相连，全部为 3.3 V LVCMOS 电平，无需电平转换。系统"
        "主要器件如表 2-1 所示。"
    ))
    caption(doc, "表 2-1  系统主要器件清单")
    table(doc, ["部件", "型号 / 规格", "说明"], [
        ["主控 FPGA", "高云 GW2A-LV18PG256CC8/I7", "50 MHz 系统时钟，控制逻辑全部片内实现"],
        ["角度传感器", "WDD35D4 导电塑料电位器", "有效电气角 345°±2°，独立线性度 0.1%"],
        ["模数转换", "AD9200（10 bit，20 MSPS）", "并行输出，12.5 MHz 采样，1 ms 16 点平均"],
        ["编码器", "增量式编码器 11 线", "四倍频 44 counts/电机圈，经 30∶1 减速后 1320 counts/摆臂圈"],
        ["电机驱动", "TB6612FNG", "单路 H 桥（另一路空置），PWM 20 kHz"],
        ["执行电机", "直流减速电机 12 V", "额定转速约 620 r/min，减速比 30∶1"],
        ["人机交互", "ESP32 + ST7789 240×320 + 4 按键", "MicroPython，115200 bps UART，Wi-Fi 网页"],
    ], [3.4, 6.6, 4.6], align_left_cols=(2,))

    h3(doc, "2.2.2 机械设计介绍")
    para(doc, (
        "机械本体为一阶旋转倒立摆，由底座、立柱、摆臂、摆杆与两处转动副组成。摆臂由电机经 30∶1 减速器"
        "驱动，绕竖直轴在水平面内回转；摆杆通过一对微型轴承铰接在摆臂末端，可在竖直平面内自由摆动。"
        "编码器与电机尾轴同轴，测量摆臂的回转角 φ；角度传感器与摆杆铰接轴同轴，直接测量摆杆相对竖直"
        "方向的夹角 θ。机械本体与整机实物如图 2-2 所示。"
    ))
    figure(doc, "hardware.png", 7.2, "图 2-2  机械本体与整机实物")
    para(doc, (
        "机械设计重点解决了转动惯量匹配与回差两个问题。摆杆选用轻质管材并在末端配置可调配重，使摆杆的"
        "固有摆动频率与电机的加速能力相匹配：摆杆过轻易被气流扰动，过重则电机加速能力不足、起摆时间"
        "显著变长。摆臂与电机轴之间采用抱紧式联轴器，减小正反向切换时的空程；铰接副选用带预紧的微型"
        "轴承，使摆杆自由摆动的衰减时间达到数秒量级。图 2-2 中可以看到电机安装在底板下方、摆臂位于"
        "底板上方，编码器与电位器分别位于两处转动副的轴端，整机只有一台电机、一个编码器和一个 ADC 通道。"
    ))

    h3(doc, "2.2.3 电路各模块介绍")
    para(doc, (
        "（1）角度采集链路。WDD35D4 为三端电位器接法，两端加基准电压，滑动端输出与转角成正比的模拟"
        "电压，经 RC 低通后送入 AD9200 的模拟输入。AD9200 工作于并行输出模式，采样时钟由 FPGA 将"
        "50 MHz 四分频得到 12.5 MHz。FPGA 在采样时钟的下降沿锁存 10 bit 数据，以避开数据变化沿；"
        "随后把数据同步到 50 MHz 域，左移 2 位扩展为 12 bit，使角度码值与后续定点运算的字长匹配。"
    ))
    para(doc, (
        "（2）编码器接口。编码器 A/B 相为 3.3 V 推挽输出，FPGA 侧使能内部上拉。两相脉冲先经两级触发器"
        "同步到 50 MHz 域，避免异步采样引起的亚稳态；随后进入稳定时间滤波，只有当电平连续 100 μs "
        "保持不变时才确认一次状态跳变，从而滤除 PWM 开关瞬间耦合进来的窄脉冲。滤波窗口的选择是一个"
        "明确的折中：100 μs 可跟踪约 2727°/s，足以覆盖起摆与手动快速转动；若取 1 ms，则只能跟踪约"
        "273°/s，快速摆动时会出现“编码器不更新、位置环误判”的现象。"
    ))
    para(doc, (
        "（3）电机驱动。TB6612FNG 的一路 H 桥驱动直流减速电机，方向由 IN1/IN2 两路电平决定，转速由"
        "PWM 占空比决定。PWM 载波由 50 MHz 计数分频产生，周期 2500 个时钟，对应 20 kHz；占空比以 1% "
        "为步进（0~100），比较值为占空比码值乘以 25。占空比只在 PWM 周期边界锁存，避免中途改写比较值"
        "产生窄脉冲。20 kHz 高于人耳敏感频段，也远高于电机电气时间常数的倒数，电流连续、转矩脉动小。"
    ))
    para(doc, (
        "（4）交互与通信。ESP32 的 UART 为 3.3 V 电平，与 FPGA 的 I/O 银行电压一致，可直接交叉连接"
        "TX/RX，无需电平转换与流控。TFT 屏、4 个按键与 Wi-Fi 均由 ESP32 直接管理，FPGA 只负责实时"
        "回路与串口。FPGA 侧的关键引脚分配如表 2-2 所示。"
    ))
    caption(doc, "表 2-2  FPGA 引脚分配")
    table(doc, ["信号", "FPGA 引脚", "说明"], [
        ["clk_50m / rst_n", "C6 / P8", "50 MHz 时钟 / 复位（低有效）"],
        ["adc_data_in[9:0]", "L15 K10 A15 E10 K15 / J15 F16 F10 E16 D16", "ADC 并行数据 D9~D0"],
        ["adc_clk", "M15", "12.5 MHz 采样时钟"],
        ["enc_a / enc_b", "J14 / J12", "编码器 A/B 相"],
        ["pwm_out / in1 / in2", "J11 / G11 / F13", "PWM 调速与方向电平"],
        ["fpga_tx / fpga_rx", "N16 / N15", "FPGA→ESP32 / ESP32→FPGA"],
        ["key1 / key2", "A10 / N8", "启停与起摆 / 锁存当前位置"],
        ["sine_sw", "C8", "正弦摆动拨码开关（低有效）"],
        ["led / led_sine", "C14 / B16", "运行指示 / 正弦进行指示"],
    ], [4.4, 6.4, 3.8], align_left_cols=(2,))

    h2(doc, "2.3 软件系统介绍")
    h3(doc, "2.3.1 软件整体介绍")
    para(doc, (
        "软件分为 FPGA 端与 ESP32 端两部分。FPGA 端为纯硬件逻辑，共 14 个源文件：顶层 top.v、角度采集 "
        "adc.v、编码器解码 encoder.v、按键消抖 key_filter.v（三路例化）、PWM 生成 PWM.v、定点 PID "
        "pid_core.v（两路例化）、起摆 swing_up.v、旋转轨迹 rotate_ctrl.v 与 ramp_move.v、正弦表 "
        "sine_lut.v（两路例化）、命令解帧 angle_cmd.v、串口收发 uart_rx.v / uart_tx.v、遥测组帧 "
        "telemetry.v。模块划分与数据流如图 2-3 所示。"
    ))
    figure(doc, "fig_2_4.png", 14.6, "图 2-3  FPGA 内部模块结构与数据流")
    para(doc, (
        "顶层承担四类职责：一是例化并连接各功能模块，统一时钟与复位；二是运行三状态机（待机、起摆、"
        "平衡），处理 K1 启停/起摆与 K2 锁存语义；三是合成外环输出、速度前馈与摩擦前馈，并完成倾角"
        "指令的限幅与倒杆保护；四是驱动遥测组帧，把角度、目标、编码器、两环输出、占空比与状态位打包"
        "上送。所有时序逻辑统一工作在 50 MHz 域，仅 ADC 数据在采样时钟下降沿被锁存后立即同步过来，"
        "因此不存在跨时钟域的数据通路问题。"
    ))
    para(doc, (
        "ESP32 端为 MicroPython 固件，按“初始化—主循环”两段组织。初始化阶段严格按“UART → Wi-Fi → "
        "SPI → HTTP 监听 → 业务模块”的顺序进行，原因是 ESP32 的 DMA 描述符、UART 环形缓冲、Wi-Fi "
        "收发缓冲与 lwIP socket 都要从同一块内部 DRAM 中分配连续内存，而 MicroPython 的堆是按需增长的："
        "一旦先导入界面与字库把堆撑大，再申请这些资源就会报“out of memory”或“ENOBUFS”。主循环约 5 ms "
        "一轮，依次完成按键事件读取、串口收帧、网页请求处理与 Wi-Fi 维护，全过程非阻塞，其流程如"
        "图 2-4 所示。"
    ))
    figure(doc, "fig_2_5.png", 8.6, "图 2-4  ESP32 端软件流程")

    h3(doc, "2.3.2 软件各模块介绍")
    para(doc, (
        "（1）角度采集 adc.v。模块以 50 MHz 四分频输出 12.5 MHz 采样时钟，在时钟下降沿锁存 10 bit "
        "数据并左移 2 位得到 12 bit 角度码；计数器每 62.5 μs 触发一次累加，1 ms 内累加 16 次后右移 4 位"
        "得到平均值。16 个采样点在窗口内均匀分布，对白噪声而言标准差降为 1/4，等效信噪比改善约 12 dB；"
        "代价是约 0.5 ms 的等效群延迟，在整定倾角环时需要计入。输出每 1 ms 更新一次，与倾角环的 5 ms "
        "节拍严格对齐。"
    ))
    para(doc, (
        "（2）编码器解码 encoder.v。A/B 两相先做两级同步，再做 100 μs 稳定时间滤波，随后按正交编码的"
        "状态迁移做四倍频计数。计数值以 32768 为中心偏置，形成 16 bit 有符号量，便于外环直接做差；"
        "上电后先等待第一次滤波状态稳定，把历史状态对齐后再开始计数，避免上电瞬间产生错误脉冲。"
        "四倍频把分辨率提高到单相计数的 4 倍（摆臂 0.273°/count），同时由计数增减隐含转向信息，无需"
        "额外的方向引脚。编码器在 50 ms 节拍上的差分即为摆臂角速度，本设计中该量没有单独构成速度环，"
        "而是通过外环的微分项参与阻尼。"
    ))
    para(doc, (
        "（3）定点 PID pid_core.v。控制器采用位置式结构，离散形式为 u(k) = Kp·e(k) + Ki·Σe + "
        "Kd·[y(k−1) − y(k)]，其中 y 为测量值；参数以 16.16 定点表示，乘加结果为 32.32，最后做对称"
        "四舍五入并限幅到 ±100。D 项对测量值微分，因此目标阶跃（例如起摆切换、外环输出变化）不会"
        "在微分项上产生冲击；微分后接一阶低通（移位 1，α = 0.5）抑制量化噪声。积分项按“误差码值”"
        "限幅（倾角环 500、转角环 1000），并在输出饱和且误差同向时停止积分，构成条件积分抗饱和。"
        "模块另有三个工程化处理：run 为 0 时彻底清零；run 上升沿预置上一拍测量值，消除启动瞬间的"
        "微分踢动；hold_int 为 1 时清空并保持积分为 0，供定位运动期间使用。两级回路的整定参数如"
        "表 2-3 所示。"
    ))
    caption(doc, "表 2-3  双环 PID 参数与限幅")
    table(doc, ["回路", "周期", "Kp", "Ki", "Kd", "输出限幅"], [
        ["倾角环（内环）", "5 ms", "0.30", "0.01", "0.40", "±100（对应 100% 占空比）"],
        ["转角环（外环）", "50 ms", "0.40", "0", "1.50", "±60 码（约 ±5° 倾角）"],
    ], [3.6, 2.2, 1.8, 1.8, 1.8, 3.4])
    para(doc, (
        "参数以 16.16 定点写在 top.v 的 localparam 中，乘加结果为 32.32，最后做对称四舍五入。整定时"
        "先在转角环置零的条件下调倾角环的 Kp 与 Kd，能“接住”摆杆后再加位置环，最后补积分。"
    ))
    para(doc, (
        "（4）起摆 swing_up.v。模块以 5 ms 节拍工作：先算相对平衡点的角度误差 e（按 12 bit 回绕），"
        "再对 e 做 5 ms 差分并经一阶低通得到角速度 v；随后用 |e| 查 v_need 表得到“升到竖直所需的最小"
        "角速度”。当 |v| 大于死区且小于 v_need、且 |e| 仍在捕获窗口之外时，按 u = sign(v·cos e) 输出"
        "满幅泵能量；起摆开始后的前 100 ms 用 35% 的定向踢动代替能量泵，以打破 v = 0 时方向未定义的"
        "死点。|e| 进入 300 码以内且 |v| ≤ 8 counts/5 ms 连续 3 个节拍时输出捕获脉冲。超时 4 s 未捕获"
        "则输出超时脉冲，由顶层退回待机。"
    ))
    para(doc, (
        "（5）轨迹模块 rotate_ctrl.v 与 ramp_move.v。ramp_move 是确定性的梯形速度发生器：每个 1 ms "
        "按加速度上限增加速度，达到 V_max 后匀速，并根据剩余距离与制动距离（v² + v·A ≥ 2A|e|）提前"
        "减速，末端在剩余 2 counts 且速度足够小时直接吸附到目标。命令语义为“一帧一次相对增量”："
        "空闲时以当前实际位置为基准，运动中把增量累加到原目标而不打断速度曲线；一次连续移动的总行程"
        "限制在 360° 内。rotate_ctrl 负责在斜坡与正弦之间切换、维护正弦中心与增益，并把速度参考 v_ref "
        "送给顶层做前馈。正弦由 256 点 Q15 表与 32 位相位累加器产生，频率 0.5 Hz、幅度 8°，增益按"
        "固定步长在约 1 s 内渐入渐出。"
    ))
    para(doc, (
        "（6）命令解帧 angle_cmd.v 与串口底层。uart_rx 完成 8N1、115200 bps 的字节接收；angle_cmd "
        "按“AA 55 + 高字节 + 低字节 + 0D”逐字节推进，对数据字节完全透明（数据可以是 AA/55/0D），"
        "帧尾不符时把当前字节当作可能的帧头重新同步，帧内 20 ms 未收齐则复位状态机。解析出的角度为"
        "有符号 16 bit，超出 ±180° 按边界截断，避免异常帧把摆臂目标拉飞。"
    ))
    para(doc, (
        "（7）遥测 telemetry.v。模块每 10 ms 锁存一整帧数据并逐字节发送，帧长 34 字节，帧头 AA 55，"
        "帧尾 0D 0A，CRC-16/CCITT-FALSE 覆盖前 30 字节。一帧内同时给出角度原始值、编码器原始值、"
        "角度目标、位置误差、两环 PID 输出、占空比、状态位、位置环输出偏移、编码器增量与毫秒时间戳，"
        "主机据此可以检测丢帧、错帧并还原控制过程。发送状态机在上一帧未发完时置 overrun 标志，"
        "帧周期还会按波特率自动放宽，保证低波特率下也不会自我覆盖。"
    ))
    para(doc, (
        "（8）顶层状态机与安全逻辑。状态机只有三个状态：S_IDLE 待机（电机刹车、两级 PID 清零）、"
        "S_SWING 起摆（电机由 swing_up 驱动，不受倒杆保护限制）、S_BALANCE 平衡（两环闭环，倒杆保护"
        "生效）。进入平衡的同一拍，顶层把当前摆臂转角锁存为外环目标，避免一接管就要求摆臂“回到起摆前"
        "的位置”。停机时方向字与占空比被强制为 0，杜绝 PID 残值驱动电机；K1 在三个状态下语义不同，"
        "但都能在任意时刻立即停机。"
    ))
    para(doc, (
        "（9）ESP32 端固件。uart.py 负责收帧与下发：接收缓冲扩到 1 KB，解析时只保留缓冲区里最新的一帧"
        "完整且校验通过的数据，旧帧直接丢弃，因此界面偶尔被刷屏拖慢也不会积压；CRC 用 256 项查表实现。"
        "ui.py 实现两个界面：指针表盘（刻度、指针、角度数值）与旋转角设置（符号/百位/十位/个位四个"
        "可编辑位），绘制时把同色连续像素合并成矩形填充，以降低 SPI 事务数。tmp.py 是主循环与按键状态机："
        "按键的按下/松开沿都在 Pin 中断里记录时间戳，主循环只取事件，30 ms 消抖，因此即使一次刷屏花掉"
        "几十毫秒也不会丢按键。web.py 是一个单连接、非阻塞的极简 HTTP 服务，页面从 flash 分块流式发送，"
        "每条请求最多收发 512 字节，路由 /s?x=角度 复用 uart 的组帧函数，保证网页与按键走同一条协议。"
    ))

    h3(doc, "2.3.3 控制算法设计")
    para(doc, (
        "（1）被控对象模型。设摆杆与竖直方向夹角为 θ，摆臂转角为 φ，摆杆质心到铰点的距离为 l，摆杆"
        "绕铰点的转动惯量为 J，摆臂回转半径为 r，电机输出转矩为 T，忽略库仑摩擦与传动间隙，由"
        "拉格朗日方程可得小角度线性化模型（撇号表示对时间求导）[[1,2]]："
    ))
    p = doc.add_paragraph(style="Normal")
    p.alignment = WD_ALIGN_PARAGRAPH.CENTER
    p.paragraph_format.space_before = Pt(3)
    p.paragraph_format.space_after = Pt(3)
    _set_run_font(p.add_run("(J + m·l²)·θ'' − m·g·l·θ = −m·l·r·φ''"), 11)
    p = doc.add_paragraph(style="Normal")
    p.alignment = WD_ALIGN_PARAGRAPH.CENTER
    p.paragraph_format.space_before = Pt(0)
    p.paragraph_format.space_after = Pt(6)
    _set_run_font(p.add_run("(J_a + m·r²)·φ'' + b·φ' = T − m·l·r·θ''"), 11)
    para(doc, (
        "该模型表明：摆杆通道存在一个位于右半平面的极点（ω_p ≈ √(m·g·l / (J + m·l²))），开环不稳定，"
        "必须依靠反馈镇定；摆臂通道近似为含阻尼的积分环节，可由转矩直接控制其转角。写成功率形式，"
        "角度通道近似为 K_θ/(s² − ω_p²)，位置通道近似为 K_φ/s²。这正是采用“倾角内环 + 转角外环”"
        "串级结构的依据：内环先把不稳定极点左移、把摆杆“扶住”，外环再对已镇定的对象做位置控制。"
    ))
    para(doc, (
        "（2）串级结构与带宽分离。倾角环作为内环，5 ms 更新一次，负责快速抑制倾角扰动；转角环作为"
        "外环，50 ms 更新一次，负责把摆臂缓慢地推向目标。两者周期相差整十倍，外环每次动作时内环已经"
        "完成了十次修正，因此外环可以近似把内环视为理想跟随，两级参数能够独立整定。若把两者做成同一"
        "速率，外环的每次修正都会与内环的暂态叠加，表现为“扶得住但走不准”或“走得准但一路晃”。"
    ))
    figure(doc, "fig_2_6.png", 14.6, "图 2-5  位置—角度双闭环控制框图")
    para(doc, (
        "（3）倾角指令与加速度约束。外环 PID 的输出不是 PWM，而是倾角目标相对平衡点的偏移 "
        "loc_cmd，顶层按 θ_ref = CENTER − loc_cmd 得到倾角环目标，并把 loc_cmd 限幅在 ±60 码（约 ±5°）"
        "以内。由 a ≈ g·tanθ 可知，5° 倾角对应约 0.86 m/s² 的加速度上限，与梯形斜坡设定的 1000 counts/s² "
        "（摆臂小半径下约 0.7 m/s²）同一量级。也就是说，“摆臂能加多快”与“允许摆杆倾斜多少”在设计上"
        "是一致的，不需要另设一套轨迹限速。"
    ))
    para(doc, (
        "（4）前馈与摩擦补偿。纯位置环在斜坡匀速段需要靠误差积累才能维持速度，表现为“跟不上、末端"
        "拖尾”。顶层按 v_ref（Q16 counts/ms）乘以系数 KV_FF 得到倾角前馈，限幅 ±12 码后与外环输出"
        "相加，使倾角指令“提前”给出；另按速度方向（静止时按误差方向）叠加 ±4 码的摩擦前馈，补偿减速器"
        "与轴承的静摩擦。两项前馈都作用在倾角指令层，不改变 PID 结构，因此可以在线单独关掉做对比。"
    ))
    para(doc, (
        "（5）起摆控制。起摆的核心是把摆杆从下垂位置（θ = 180°）泵升到竖直位置附近。记摆杆角速度"
        "ω = θ'，以摆杆机械能 E = ½Jω² + m·g·l·cosθ 为目标量，静止直立时 E₀ = m·g·l。对“摆杆 + 支点"
        "加速度”模型，能量变化率为 dE/dt = l·a·ω·cosθ，因此在“平衡环能稳定”的符号约定下，取"
        " u = sign(ω·cosθ) 即可持续注入能量[[6]]。仅按此方向泵能量会使摆杆越摆越快直至整周旋转，"
        "所以再引入“升到竖直所需最小角速度”门限："
    ))
    p = doc.add_paragraph(style="Normal")
    p.alignment = WD_ALIGN_PARAGRAPH.CENTER
    p.paragraph_format.space_before = Pt(3)
    p.paragraph_format.space_after = Pt(6)
    _set_run_font(p.add_run("v_need(e) = √(2K(1 − cos(π|e|/2048)))，K = (g/l)·(T·2048/π)²"), 11)
    para(doc, (
        "其中 T = 5 ms 为差分周期，|e| 为相对平衡点的角度偏差。只有当 |v| < v_need 时才继续泵能量，"
        "因此摆杆能量接近“刚好到顶”时自动停止注入，顶部速度被限制在可捕获范围内。实现上 v_need 被"
        "预先算成 33 项查表（按 |e|/64 索引，l = 0.30 m），运行时只做一次查表与比较，没有开方与除法。"
    ))
    para(doc, (
        "（6）起摆—捕获—平衡的交接。状态迁移如图 2-6 所示。捕获判据同时约束三个量：角度偏差小于"
        "300 码、角速度绝对值不超过 8 counts/5 ms、且连续满足 3 个 5 ms 节拍。三者同时成立才切换，"
        "避免“角度进了窗口但速度还很大”时接管导致的翻转。切换的同一拍完成三件事：外环目标锁存为当前"
        "摆臂转角、两级 PID 历史清零、电机输出由起摆驱动切换到倾角环输出。起摆超时（4 s）或平衡中"
        "倒杆（±500 码）都会回到待机并撤销自动触发，需要按 K1 重新起摆，这样无人看守时不会无限次踢摆。"
    ))
    figure(doc, "fig_2_7.png", 11.6, "图 2-6  起摆—捕获—平衡三状态机")
    para(doc, (
        "（7）定位与正弦。定位目标是让摆臂平滑移动到设定角度并静止。梯形斜坡给出位置目标，外环 PID "
        "跟踪该目标，速度前馈抵消跟踪滞后，三者在运动中同时生效。由于外环输出被限幅在 ±60 码，"
        "无论目标阶跃多大，倾角指令的变化幅度都受限，摆杆不会因为“要求摆臂立刻到位”而大幅倾斜。"
        "轨迹未收敛期间，顶层把两环的 hold_int 置 1，清空并保持积分，避免旧积分在运动结束后把摆臂"
        "往反方向拉；轨迹收敛后积分从 0 重新开始。正弦摆动复用同一条目标通路，只是目标由相位累加器"
        "实时计算，因此同样受限幅与前馈保护。"
    ))

    h2(doc, "2.4 通信协议")
    para(doc, (
        "FPGA 与 ESP32 之间为单向命令 + 单向遥测，共用 115200 bps、8N1，无流控。命令帧固定 5 字节，"
        "格式为 AA 55 | ANGLE_H ANGLE_L | 0D，角度为有符号 16 bit、大端、单位度，超出 ±180° 时按边界"
        "截断；帧内 20 ms 未收齐则复位解帧状态机。命令只在平衡状态生效，待机与起摆期间收到的帧直接"
        "丢弃。命令帧定义如表 2-4 所示。"
    ))
    caption(doc, "表 2-4  命令帧定义（5 字节）")
    table(doc, ["字节", "字段", "取值", "说明"], [
        ["0", "帧头 1", "0xAA", "固定"],
        ["1", "帧头 2", "0x55", "固定"],
        ["2", "ANGLE_H", "有符号高字节", "角度高 8 位（大端先发）"],
        ["3", "ANGLE_L", "有符号低字节", "角度低 8 位"],
        ["4", "帧尾", "0x0D", "不匹配时按 AA 重新同步"],
    ], [2.2, 3.6, 4.4, 4.6])
    para(doc, (
        "遥测帧固定 34 字节，100 Hz 发送，占用约 34 kbit/s（115200 bps 的 30%）。帧内包含序号与 32 位"
        "毫秒时间戳，接收端可据此统计丢帧与端到端延时；CRC-16/CCITT-FALSE 覆盖前 30 字节，帧尾 0D 0A"
        "便于串口助手直接查看。字段定义如表 2-5 所示。"
    ))
    caption(doc, "表 2-5  遥测帧格式（34 字节，CRC 覆盖字节 0~29）")
    table(doc, ["字节", "内容", "说明"], [
        ["0~1", "AA 55", "帧头"],
        ["2~3", "angle_raw", "12 bit 摆杆倾角码值，高字节在前"],
        ["4~5", "保留", "固定 0，兼容旧版"],
        ["6~7", "encoder_pos", "16 bit 编码器原始计数（中心 32768）"],
        ["8", "协议版本", "0x02"],
        ["9", "序号", "每帧加 1，用于统计丢帧"],
        ["10~13", "时间戳", "32 bit 毫秒计数，小端"],
        ["14~15", "angle_target", "倾角环目标（含外环偏移与前馈）"],
        ["16~17", "loc_error", "转角环误差 = 目标 − 实测"],
        ["18", "angle_pid_out", "倾角环输出，−100~+100"],
        ["19", "loc_pid_out", "转角环输出"],
        ["20", "motor_out", "送 PWM 的带符号占空比"],
        ["21", "duty", "实际占空比 0~100"],
        ["22", "flags", "bit0 run、bit1 in_window、bit2 loc_sat、bit3 angle_sat、bit4 overrun、bit5 move_fault、bit6 swing"],
        ["23", "loc_cmd", "限幅后的外环倾角偏移"],
        ["24~25", "angle_error", "倾角环误差"],
        ["26~27", "delta", "本帧编码器增量"],
        ["28~29", "PPR / ADC_BITS", "11 / 12，供上位机换算"],
        ["30~31", "CRC16", "CCITT-FALSE，低字节在前"],
        ["32~33", "0D 0A", "帧尾"],
    ], [2.4, 4.4, 7.8], align_left_cols=(2,))

    h2(doc, "2.5 网络化控制与 AI 接入设计")
    para(doc, (
        "本作品的实时回路完全在片内，网络不参与任何一次采样或运算，只承担“监督、遥操作与数据”三类"
        "任务。这一分工不是权宜之计，而是面向工业现场的选择：真实装置（云台、AGV、机械臂、实验平台）"
        "往往需要远程设定、集中监控与算法迭代，但公网与无线链路不可能提供确定性时延。若把控制律搬进"
        "云端，网络的一次抖动就足以让欠驱动系统失稳；反过来，若装置完全封闭，它又无法融入现代工业的"
        "数据与算法体系。本设计把两者拆开：现场负责安全，网络提供能力。"
    ))

    h3(doc, "2.5.1 三层结构与数据流")
    para(doc, (
        "系统按“现场实时层—边缘网关层—网络与云端”三层组织，如图 2-7 所示。现场实时层是 FPGA 内的"
        "全部控制逻辑：5 ms 倾角环、50 ms 转角环、20 kHz PWM、三级指令整形、三状态机与倒杆保护，每"
        "10 ms 锁存一帧完整遥测。边缘网关层是 ESP32：向下以 115200 bps 与 FPGA 交换 34 字节遥测与"
        "5 字节命令，向上以 HTTP/WebSocket/MQTT 提供服务；它承担协议转换、二次限幅、断线重连与数据"
        "缓存，是“尽力而为”网络与“确定性”现场之间唯一的耦合点。网络与云端则包括手机网页、上位机"
        "监控、时序数据库与训练集群。"
    ))
    figure(doc, "fig_2_8.png", 14.6, "图 2-7  网络化控制与 AI 接入的三层架构")
    para(doc, (
        "上行数据为 34 字节、100 Hz 的遥测帧（约 34 kbit/s，占 115200 bps 链路的 30%），包含角度、"
        "转角、两环输出、占空比、状态位、序号与 32 位毫秒时标；下行数据为 5 字节命令，只在目标或模式"
        "变化时发送。这样的非对称设计是刻意的：状态需要连续、密集地“看”，而目标只需要离散、稀疏地"
        "“改”，把带宽留给观测，才能让远程操作者对上位机的曲线有足够的信心。"
    ))

    h3(doc, "2.5.2 网络不确定性的工程化处理")
    para(doc, (
        "网络化控制真正困难的地方不是“连得上”，而是“连不上时仍然安全”。经典 NCS 研究指出，时延与"
        "丢包会改变闭环系统的极点分布，严重时使原本稳定的控制器失稳[[13,14]]。本设计因此不把控制律"
        "放进网络，而是从五个方面把不确定性挡在实时环之外。"
    ))
    para(doc, (
        "（1）时钟隔离与写入安全。控制节拍由片内 50 MHz 计数器产生，与网络时钟无关；网络侧只能写"
        "“目标角度、模式”等少数寄存器，由 FPGA 在节拍边界统一采样，不存在异步写入撕裂采样值的可能。"
        "换言之，网络延迟再大，也只是“目标晚一点到”，不会让控制周期变长或变短。"
    ))
    para(doc, (
        "（2）三级指令整形。任何来源的指令（按键、网页、云端）都要依次通过：协议层 ±180° 截断与"
        "20 ms 帧超时重同步；轨迹层梯形斜坡限制（27°/s、1000 counts/s²）；执行层 ±60 码倾角指令限幅。"
        "三级串联的结果是，即使上位机发来一个“瞬间转 180°”的误操作，机构看到的也只是一条受限的"
        "加减速曲线，摆杆不会因为目标突跳而失稳。"
    ))
    para(doc, (
        "（3）超时保持与看门狗。链路中断时，FPGA 保持当前目标继续平衡，不进入任何“等待网络”的状态；"
        "网关检测到掉线后每 10 s 重连一次，且重连过程不阻塞刷屏与收帧；若网关整体复位，现场环路仍按"
        "最后一次有效目标运行，直到操作者重新下达指令。对工业遥操作而言，“失联即停”并不总是安全——"
        "对倒立摆这类本身不稳定的对象，“失联即保持”才是更合理的选择。"
    ))
    para(doc, (
        "（4）链路质量的可观测性。遥测帧带序号与毫秒时标，接收端可以据此统计丢帧率、单向时延与抖动，"
        "而不是凭“感觉卡不卡”判断链路；CRC-16 与帧尾校验保证进入控制器的数据没有一位错误。可观测是"
        "可管理的前提，这一点在远程运维时尤其重要。"
    ))
    para(doc, (
        "（5）延迟补偿（设计）。在掌握单向时延后，有两种低成本补偿：一是把下行命令由“绝对目标”改为"
        "“相对增量”，使控制效果对时延不敏感；二是按“剩余距离 + 时延 × 当前速度”对目标做超前修正，"
        "相当于在目标层做一次 Smith 预估。两者都不改动内环结构，属于可开关的增强项。"
    ))
    caption(doc, "表 2-6  网络通道的设计预算")
    table(doc, ["环节", "设计值", "说明"], [
        ["采样与控制", "5 ms / 50 ms", "片内计数器分频，不受网络影响"],
        ["遥测帧", "34 B @100 Hz ≈ 34 kbit/s", "约占 115200 bps 的 30%"],
        ["串口单向传输", "≈ 3.0 ms / 帧", "34 B × 10 bit ÷ 115200"],
        ["Wi-Fi 局域网往返", "10~50 ms（设计假设）", "与路由器、信道占用有关，需实测"],
        ["网页 / 云端指令端到端", "≤ 100 ms（设计目标）", "含浏览器渲染与人工操作时间"],
        ["指令生效时刻", "下一个 50 ms 外环节拍", "经斜坡限速后平滑执行"],
        ["断链保持", "立即保持当前目标", "本地闭环不中断，恢复后可继续"],
    ], [4.2, 5.2, 5.2], align_left_cols=(2,))

    h3(doc, "2.5.3 面向工业现场的遥操作场景")
    para(doc, (
        "（1）远程设定与集中监控。一台网关管理一台装置，云端按设备编号聚合：操作者在监控室里即可看到"
        "多台倒立摆、云台或实验平台的角度曲线与状态位，并批量下发目标。对教学实验室而言，这意味着"
        "“一人管多台”；对产线而言，这是设备联网改造的最小闭环。"
    ))
    para(doc, (
        "（2）危险或不可达环境。高温、辐射、水下、高空等场景不适合人员靠近，操作者可以在安全区远程"
        "设定与启停；因为安全逻辑（限幅、斜坡、倒杆保护、看门狗）都在现场，通信质量下降只会降低"
        "“操作精细度”，不会把装置变成失控的远端执行器。"
    ))
    para(doc, (
        "（3）数字孪生与过程回放。100 Hz 全状态遥测加毫秒时标，足以驱动三维模型实时复现摆杆与摆臂的"
        "运动，也足以在故障后逐帧回放“命令—状态—输出”的对应关系，把“事后说不清”变成“有据可查”。"
        "这正是工业现场对网络化提出的第二个要求：不仅要能控，还要能追溯。"
    ))
    para(doc, (
        "（4）远程运维与参数整定。把 PID 参数、捕获门限、前馈系数做成可写寄存器后，工程师无需到现场"
        "重新综合 FPGA，即可做参数 A/B 对比；配合影子模式，还能让新参数先“只算不用”，确认效果后再"
        "切换。对迭代频繁的控制类设备，这一点的价值往往超过“远程启停”本身。"
    ))

    h3(doc, "2.5.4 AI 控制接入路径")
    para(doc, (
        "网络化带来的不只是“遥控”，更重要的是把装置变成了一个可持续产出数据的节点。本作品的采样与"
        "通信链路恰好满足学习型控制对数据的要求：状态（倾角、转角、两环输出）、动作（PWM 占空比与"
        "方向）、时间（毫秒时标）在同一时间基上对齐，100 Hz 的采样率覆盖了倒立摆的主要动态，"
        "带序号的帧又保证了时间序列不缺段。以深度强化学习为代表的端到端策略已在多类连续控制任务上"
        "证明了可行性[[15]]，而这类方法真正的门槛在于数据质量与仿真保真度——这正是本作品的数据链路"
        "试图提前解决的问题。"
    ))
    para(doc, (
        "策略的接入按风险从低到高分为三条路径。其一是“监督 + 前馈”：AI 不直接输出控制量，只学习"
        "摩擦、间隙、电机非线性等难以建模的补偿项，叠加到现有 PID 上，稳定性仍由 PID 保证。其二是"
        "“增益调度”：由 AI 根据工况（起摆、平衡、定位、负载变化）在线选择 PID 参数组，控制结构不变，"
        "相当于把人工整定经验固化为策略。其三是“直接策略”：用强化学习直接输出倾角指令或占空比，"
        "在仿真中训练后迁移到实物（sim2real）。三条路径可以逐级推进，前一条跑通再上后一条。"
    ))
    para(doc, (
        "训练环境不需要另起炉灶：sim/swing/model.py 已经建立了“摆杆 + 支点加速度”的闭环模型，把摆长、"
        "摩擦、电机增益、量化噪声做成随机化区间，即可作为强化学习的仿真环境；模型与 RTL 共用同一套"
        "控制接口，训练出的策略可以先用 1 MHz 测试平台做回归，再上实物。"
    ))
    para(doc, (
        "安全包络是所有 AI 路径的共同前提：策略输出必须经过与人工指令完全相同的三级整形、看门狗与"
        "倒杆保护，并且支持“影子模式”——策略只计算、不执行，与 PID 的输出并行记录，待统计指标"
        "（超调、恢复时间、能耗）稳定优于基线后再切换。这样，AI 的引入是一次可回退的工程升级，"
        "而不是一次押上稳定性的赌博。"
    ))
    para(doc, (
        "需要说明的是资源约束：当前工程 DSP 已占用 17.25/24（72%），若要在片内直接推理多层网络，"
        "需要把乘加运算分时复用或裁剪网络规模；更现实的方案是“网关推理 + 片上执行”，即 ESP32 或上位机"
        "以 50~100 ms 的节拍输出参考轨迹或前馈量，5 ms 内环仍由 FPGA 的 PID 兜底。这也正是本设计"
        "坚持“网络只写目标”的原因：无论策略跑在哪里、算得多慢，现场总有一个确定性的环在保底。"
    ))

    # =====================================================================
    h1(doc, "第三部分  完成情况及性能参数")

    h2(doc, "3.1 整体介绍")
    para(doc, (
        "整机为桌面级实验装置：底板固定于实验台，电机安装在底板下方，输出轴穿过底板驱动摆臂；摆臂末端"
        "铰接摆杆，摆杆铰接轴端安装角度传感器，电机尾轴端安装编码器；FPGA 开发板、驱动板与 ESP32 交互板"
        "固定在底板侧面。整机实物见图 2-2 所示。"
    ))
    para(doc, (
        "系统上电后约 1 ms 即可输出第一帧角度平均值，100 ms 内两级 PID 进入稳态；ESP32 上电后依次完成"
        "串口、Wi-Fi、屏幕与 HTTP 初始化，屏幕显示角度表盘并在底部常驻 IP。典型操作流程为：把摆杆扶到"
        "竖直附近 → 松手（或按 K1 直接进入平衡）→ 需要演示起摆时让摆杆自然下垂并等待 0.5 s → 观察表盘"
        "与状态指示 → 用按键或手机网页下发目标角度，摆臂在保持直立的前提下转动到设定位置。"
    ))

    h2(doc, "3.2 工程成果")
    h3(doc, "3.2.1 机械成果")
    para(doc, (
        "完成了一阶旋转倒立摆机械本体的设计、加工与装配，包括底板、电机座、摆臂、摆杆、轴承座、联轴器"
        "与配重。装配后摆臂端面跳动与铰接副间隙均控制在可接受范围内，摆杆自由摆动的衰减时间达到数秒"
        "量级，满足平衡控制对低摩擦、小间隙的要求。摆杆长度与配重可调，便于通过试验选择与电机加速能力"
        "匹配的转动惯量。"
    ))
    h3(doc, "3.2.2 电路成果")
    para(doc, (
        "完成了角度采集、编码器接口、电机驱动与串口通信四部分电路的制作与调试。角度通道在静态下输出"
        "码值稳定，1 ms 平均后未见明显跳变；编码器通道在电机 20 kHz PWM 满占空比运行时无异常计数；"
        "串口在 115200 bps 下连续收发电平正常，遥测帧可被 ESP32 稳定解析。驱动板与 FPGA 板之间全部为"
        "3.3 V 电平直连，未使用电平转换。"
    ))
    h3(doc, "3.2.3 软件成果")
    para(doc, (
        "FPGA 工程共 14 个 Verilog 源文件，综合后无锁存器推断、无跨时钟域数据通路，资源占用见 3.3.5 节。"
        "ESP32 固件共 8 个 MicroPython 模块，实现了遥测解析、双界面绘制、按键状态机、Wi-Fi 连接与"
        "内置 HTTP 服务。两屏界面如图 3-1 所示：左图为角度表盘，指针 30 Hz 刷新，底部常驻 IP；右图为"
        "旋转角设置，可在符号与百/十/个位之间切换，长按 MENU 下发。"
    ))
    figure_pair(doc, ["ui_gauge.png", "ui_setting.png"], 4.8, "图 3-1  交互界面（左：角度表盘；右：旋转角设置）")

    h2(doc, "3.3 特性成果")
    para(doc, "按功能分项验证，测试条件与结果汇总见表 3-1，各项说明见后续小节。")
    caption(doc, "表 3-1  功能与性能验证汇总")
    table(doc, ["验证项", "条件 / 方法", "结果", "结论"], [
        ["解帧鲁棒性", "数据字节取 AA/55/0D、超范围角度", "9 项用例通过", "通过"],
        ["斜坡与限幅", "±90°、±45°、累加、360° 行程、跟踪保护", "全部用例通过", "通过"],
        ["PID 抗饱和", "hold_int 清积分、目标阶跃 D 踢动", "4 项用例通过", "通过"],
        ["起摆捕获", "1 MHz 模块级闭环，摆杆模型 l = 0.30 m", "0.575 s 捕获", "通过"],
        ["状态迁移", "强制下垂/捕获/超时/按键", "8 项用例通过", "通过"],
        ["定位精度", "完整 top 级联，+90° 命令", "330 counts，无过冲", "通过"],
        ["串级闭环", "完整 top + 摆杆模型", "起摆后收敛直立", "通过"],
        ["静态角度波动", "平衡状态下连续记录 60 s", "待整机复测", "待测"],
        ["抗扰恢复", "侧向轻推后记录恢复过程", "待整机复测", "待测"],
        ["连续运行", "单次启动后连续运行 10 min", "待整机复测", "待测"],
        ["网络下发与断链保持", "网页下发 +90°，中途断开热点再恢复", "待整机复测", "待测"],
        ["链路时延与丢帧", "按遥测序号与毫秒时标统计", "待整机复测", "待测"],
    ], [3.6, 6.6, 3.4, 1.8], align_left_cols=(1,))

    h3(doc, "3.3.1 反馈链与标定")
    para(doc, (
        "角度通道的标定方法是：把摆杆依次固定在 0°、±15°、±30°，读取 12 bit 码值，拟合码值—角度直线。"
        "WDD35D4 的有效电气角为 345°，对应 4096 个码值，理论灵敏度约 11.9 码/度，即 0.084°/码；"
        "平衡点码值 CENTER_ANGLE 由实测确定（当前取 2060），平衡窗口取 ±500 码。编码器通道的标定方法是："
        "记录转动前后的 encoder_pos，转过 180° 后按下式折算一圈计数："
    ))
    p = doc.add_paragraph(style="Normal")
    p.alignment = WD_ALIGN_PARAGRAPH.CENTER
    p.paragraph_format.space_before = Pt(3)
    p.paragraph_format.space_after = Pt(6)
    _set_run_font(p.add_run("ARM_COUNTS_PER_REV ≈ 2 × |Δencoder_pos| = 1320"), 11)
    para(doc, (
        "与“11 线 × 4 倍频 × 30 减速比 = 1320”的理论值一致，说明编码器分辨率与减速比标定正确。"
    ))

    h3(doc, "3.3.2 起摆验证")
    para(doc, (
        "起摆先在 Python 闭环模型中验证控制律，再把同一模块放入 RTL 测试平台。模型按“摆杆 + 支点"
        "加速度”建模（l = 0.30 m、满占空比加速度 40 m/s²、粘性摩擦 0.6 /s），从下垂静止开始，约 1.02 s "
        "到达顶部捕获窗口并切换到平衡。RTL 模块级测试平台用 1 MHz 时钟与手动 1 ms / 5 ms 脉冲驱动"
        "swing_up，接同一摆杆模型，仿真波形为："
    ))
    log_block(doc, (
        "t = 100 ms  θ = 168.4°  v = −12.0  drive = 35%\n"
        "t = 200 ms  θ = 123.7°  v = −34.0  drive = 0\n"
        "t = 400 ms  θ = 45.9°   v = −14.0  drive = 0\n"
        "t = 575 ms  CAPTURED   e = 148   v = −8.0"))
    para(doc, (
        "捕获发生在 0.575 s，捕获时角度偏差 148 码、角速度 −8 counts/5 ms，正好落在门限之内；"
        "踢动结束后能量泵只在 |v| < v_need 时输出，可以看到 200 ms 之后 drive 多次回到 0，说明"
        "“刚好到顶”的限速逻辑生效，摆杆没有出现整周旋转。状态迁移另用强制信号测试了 8 种情形"
        "（下垂计时、自动触发、捕获交接、K1 停止、K1 直接平衡、K1 手动起摆、超时、目标锁存），全部通过。"
    ))

    h3(doc, "3.3.3 自平衡与抗扰")
    para(doc, (
        "平衡验证在完整 top 上进行：摆杆模型接入 ADC 与编码器接口，按 5 ms / 50 ms 真实节拍运行，"
        "起摆捕获后切入平衡，角度在数次摆动内收敛并保持。倒杆保护按 ±500 码判定，一旦越界立即回待机"
        "并封锁输出，测试中未出现“倒杆后仍满占空比驱动”的现象。抗扰恢复与 10 min 连续运行的量化数据"
        "需要在整机上用更高帧率的记录手段复测，表中暂列为待测。"
    ))

    h3(doc, "3.3.4 角度定位")
    para(doc, (
        "斜坡与定位在 1 MHz 时钟的单元测试平台上验证，结果如下："
    ))
    log_block(doc, (
        "+90°   : 3.366 s 到 330 counts，最大速度 6554（0.10 count/ms），无过冲\n"
        "−45°   : 1.716 s 到 165 counts\n"
        "+20/+40: 目标累加为 220 counts，中途不打断速度曲线\n"
        "360°   : 行程限幅停在 1320 counts（13.247 s）\n"
        "跟踪保护: 目标超前实际超限 500 ms 后 fault = 1，目标拉回实际位置"))
    para(doc, (
        "在完整 top 的级联测试中，通过 fpga_rx 注入 +90° 命令，angle_cmd → rotate_ctrl → 外环目标"
        "的链路在 34 ms 内把目标推到 330 counts（测试使用加速斜坡参数以缩短仿真时间），说明命令解析、"
        "轨迹生成与目标装载三者的时序正确。角度换算关系为 1320 counts/圈，即 90° 对应 330 counts、"
        "45° 对应 165 counts、180° 对应 660 counts。"
    ))

    h3(doc, "3.3.5 实时性与资源占用")
    para(doc, (
        "控制节拍由 50 MHz 计数器分频得到：1 ms 时基再五分频得到 5 ms 倾角节拍，五十分频得到 50 ms "
        "转角节拍，两者相位固定，不存在累积漂移。综合与布局布线报告给出的资源占用为：逻辑 4254/20736"
        "（21%，其中 LUT 3245、ALU 1009）、寄存器 989/16125（7%）、DSP 17.25/24（72%）、CLS "
        "2444/10368（24%）、I/O 26/191（14%）。DSP 占用较高，主要来自两路 PID 的 32×32 乘法与正弦/"
        "斜坡的定点乘法。"
    ))
    para(doc, (
        "时序方面需要如实说明：工程未添加 SDC，工具按默认 100 MHz 分析，报告的最差路径位于正弦与斜坡"
        "的 32 位乘法链，Fmax 约 14.4 MHz。由于这些乘法链的输出寄存器全部由 1 ms 使能驱动，路径有"
        "约 5×10⁴ 个时钟周期的稳定时间，实际功能不受影响；但作为可复用设计，应在后续版本把乘法链拆成"
        "两级流水或改为多周期调度，并补上 50 MHz 的时序约束，使报告中的 Fmax 真正大于工作频率。"
    ))

    h3(doc, "3.3.6 网络通道与远程操作验证")
    para(doc, (
        "网络部分的验证分三步。第一步验证“通”：手机浏览器接入 ESP32 所在局域网，打开控制页下发 +90°，"
        "在 FPGA 的遥测里确认 loc_target 按斜坡爬升、摆杆全程保持直立；同时对照按键通道，确认两条路径"
        "产生完全相同的 5 字节帧——网页与按键复用同一个组帧函数，这一条可以在单元测试里直接断言。"
        "第二步验证“断”：下发过程中关闭热点，观察装置是否保持当前目标继续平衡；恢复热点后确认网关"
        "自动重连、无需重启即可继续接受指令。第三步验证“准”：用遥测帧的序号与 32 位毫秒时标统计丢帧率"
        "与端到端时延，把结果与表 2-6 的设计预算对照。"
    ))
    para(doc, (
        "判据有三条：断链期间摆杆不倒、装置不误动作；恢复后 10 s 内重新接受指令；局域网内丢帧率低于 1%、"
        "端到端时延不大于 100 ms。网页与按键复用同一组帧函数，协议一致性可由单元测试直接覆盖；时延与"
        "丢帧的量化结果仍需在整机上按上述方法复测后填入表 3-1。"
    ))

    # =====================================================================
    h1(doc, "第四部分  总结")

    h2(doc, "4.1 可扩展之处")
    para(doc, (
        "（1）控制策略升级。当前为双速率串级 PID，可在已有状态量（角度、角速度、转角、转角速度）的"
        "基础上引入 LQR 或极点配置，把人工整定换成基于模型的权重设计；起摆段也可由能量泵扩展为"
        "“能量 + 角度”混合控制，进一步缩短起摆时间。"
    ))
    para(doc, (
        "（2）观测与辨识能力。遥测已具备 100 Hz、带时间戳与 CRC 的完整状态，可直接在上位机重建"
        "角度—时间、位置—时间曲线；后续可增加参数在线写入命令，把 PID 参数、前馈系数、捕获门限做成"
        "寄存器，避免每次整定都要重新综合。"
    ))
    para(doc, (
        "（3）轨迹与功能扩展。在梯形斜坡之上可加入 S 形加减速、多段轨迹与圆弧插补；机械上可扩展为"
        "二级倒立摆、环形倒立摆，控制架构（快内环 + 慢外环 + 轨迹前馈）可以直接复用。"
    ))
    para(doc, (
        "（4）工程化改进。增加电流采样与堵转保护、编码器断线检测、参数掉电保存；把 PWM 分辨率从 1% "
        "提高到 0.1%，改善小误差时的控制平滑度；为设计补充 SDC 与流水化乘法链，使时序真正收敛。"
    ))
    para(doc, (
        "（5）网络化与云边协同。把网关的 HTTP 接口扩展为 MQTT/OPC UA，接入时序数据库与设备管理平台，"
        "即可支持多机集群、远程升级与长期趋势分析；若现场改用工业以太网或 TSN，可进一步把“尽力而为”"
        "升级为“有界时延”，让远程轨迹级遥操作成为可能。在这些场景中，本作品的“实时环 + 监督层”分层"
        "结构不需要改动，只需替换上行的承载方式。"
    ))
    para(doc, (
        "（6）学习型控制。以现有 100 Hz 数据链路采集真实工况数据，在 sim/swing/model.py 的仿真环境中"
        "训练策略，按“监督前馈 → 增益调度 → 直接策略”的次序逐步上线，并始终保留 PID 作为安全回退。"
        "若后续把网络规模扩大，还可研究“事件触发上传 + 边缘推理”的带宽—性能折中。"
    ))

    h2(doc, "4.2 心得体会")
    para(doc, (
        "这个项目最初看起来只是“把摆杆扶起来”，真正做下来才发现，难点几乎都集中在两件不写在题目里的"
        "事情上：数值的边界，和节拍的确定性。"
    ))
    para(doc, (
        "第一件让我们印象最深的事，是一次“平衡点附近突然满速”的故障。现象很怪：摆杆扶正、一按启动，"
        "电机就以 100% 占空比冲出去，参数怎么调都没用。用测试平台复现后才看清，问题不在算法而在数值："
        "积分项用 16.16 定点累加，32 位有符号整数最多只能表示 ±32768 个码值的误差，摆杆倒下时误差约"
        "2000 码，约 16 次更新（80 ms）就溢出回绕，符号翻转后直接把输出顶到 −100%；更隐蔽的是，停机"
        "时 PID 仍在每个节拍积分，等用户把摆扶正再按启动，积分早已饱和——“总在平衡位置失控”，正是"
        "因为平衡位置就是按键启动的位置。后来给积分加了对称限幅、条件积分与停机清零，并在启动沿预置"
        "测量值，故障彻底消失。这件事让我们真正理解了“定点”两个字的含义：它不是“省资源的小技巧”，"
        "而是一套必须显式设计取值范围的数值系统。"
    ))
    para(doc, (
        "第二件事是“越转越快，最后转飞”。定位功能刚做出来时，连续下发角度命令会让摆臂越转越快。"
        "原因有两层：一是轨迹由位置误差经 PD 生成，每来一帧都从当前实际位置重新起步、把速度清零，"
        "轨迹被反复打断；二是没有行程上限，外环一旦跟不上，目标就继续往前推。把“轨迹生成”和“跟踪”"
        "拆开之后问题迎刃而解：梯形斜坡自己按加速度、速度和剩余距离走，输出有界且可预测；PID 只负责"
        "跟踪，不再决定轨迹形状；再加总行程、跟踪误差、移动时间三重保护，系统就从“调参碰运气”变成了"
        "“结构上不会飞”。我们把这件事总结成一句话：好的结构设计，往往比精细的参数整定更能解决问题。"
    ))
    para(doc, (
        "第三件事发生在 ESP32 这一侧。界面一度频繁死机、串口报 EPERM、Wi-Fi 报内存不足，查了很久才"
        "明白：DMA 描述符、UART 环形缓冲、Wi-Fi 缓冲和 socket 都要从同一块内部 DRAM 里分配连续内存，"
        "而 MicroPython 的堆是按需增长的，导入界面和字库之后再申请就来不及了。把初始化顺序改成"
        "“UART → Wi-Fi → SPI → socket → 界面”，并把串口解析改成“只取最新一帧”、把网页服务改成"
        "“每轮最多 512 字节的非阻塞状态机”，系统才稳定下来。这段经历让我们体会到，嵌入式里的“顺序”"
        "本身就是一种设计约束。"
    ))
    para(doc, (
        "回头看，这个项目让我们完整地走了一遍“建模—仿真—编码—上板—整定—复盘”的流程，也让我们对"
        "FPGA 在实时控制中的价值有了具体的认识：它的优势不在于主频多高，而在于把“什么时候做什么”"
        "变成一件确定的事，并且把“多少个周期做完”变成可以数出来的资源。这种确定性，正是控制系统"
        "最需要的东西。"
    ))

    # =====================================================================
    h1(doc, "第五部分  参考文献")
    refs = [
        "胡寿松. 自动控制原理[M]. 7版. 北京: 科学出版社, 2019.",
        "刘豹, 唐万生. 现代控制理论[M]. 3版. 北京: 机械工业出版社, 2011.",
        "夏宇闻. Verilog数字系统设计教程[M]. 4版. 北京: 北京航空航天大学出版社, 2017.",
        "吴厚航. 深入浅出玩转FPGA[M]. 3版. 北京: 北京航空航天大学出版社, 2017.",
        "王金明. 数字系统设计与Verilog HDL[M]. 7版. 北京: 电子工业出版社, 2021.",
        "ÅSTRÖM K J, FURUTA K. Swinging up a pendulum by energy control[J]. Automatica, 2000, 36(2): 287-295.",
        "高云半导体. GW2A系列FPGA产品数据手册[Z]. 2023.",
        "高云半导体. Gowin云源软件用户指南[Z]. 2023.",
        "Analog Devices. AD9200: 10-Bit, 20 MSPS, 80 mW A/D Converter Data Sheet[Z]. 1999.",
        "Toshiba. TB6612FNG: Dual DC Motor Driver IC Data Sheet[Z]. 2014.",
        "Espressif Systems. ESP32 Series Datasheet[Z]. 2023.",
        "MicroPython. MicroPython Documentation[EB/OL]. https://docs.micropython.org, 2024.",
        "WALSH G C, YE H, BUSHNELL L G. Stability analysis of networked control systems[J]. IEEE Transactions on Control Systems Technology, 2002, 10(3): 438-446.",
        "ZHANG W, BRANICKY M S, PHILLIPS S M. Stability of networked control systems[J]. IEEE Control Systems Magazine, 2001, 21(1): 84-99.",
        "MNIH V, KAVUKCUOGLU K, SILVER D, et al. Human-level control through deep reinforcement learning[J]. Nature, 2015, 518(7540): 529-533.",
    ]
    for i, r in enumerate(refs, 1):
        p = doc.add_paragraph(style="Normal")
        p.alignment = WD_ALIGN_PARAGRAPH.LEFT
        p.paragraph_format.space_after = Pt(3)
        p.paragraph_format.line_spacing = 1.25
        _set_run_font(p.add_run("[%d] %s" % (i, r)), 10.5)

    # =====================================================================
    page_break(doc)
    h1(doc, "附录 A  工程文件与验证清单")

    h2(doc, "A.1 FPGA 工程源文件")
    caption(doc, "表 A-1  FPGA 工程源文件清单")
    table(doc, ["文件", "功能", "关键参数"], [
        ["top.v", "顶层、三状态机、输出选择、前馈合成", "CENTER 2060、限幅 ±60、KV_FF 100"],
        ["adc.v", "12.5 MHz 采样、16 点平均、12 bit 输出", "62.5 μs × 16 = 1 ms"],
        ["encoder.v", "两级同步、100 μs 稳定滤波、四倍频", "FILTER_CNT 5000"],
        ["pid_core.v", "16.16 定点位置式 PID", "积分限幅、条件积分、D 对测量"],
        ["swing_up.v", "踢动、能量泵、v_need 查表、捕获", "踢动 35%/100 ms，超时 4 s"],
        ["rotate_ctrl.v", "斜坡与正弦切换、增益渐入渐出", "8°、0.5 Hz"],
        ["ramp_move.v", "梯形速度斜坡、增量累加、三重保护", "27°/s、1000 counts/s²"],
        ["sine_lut.v", "256 点 Q15 正弦表", "两路例化（sin/cos）"],
        ["angle_cmd.v", "5 字节命令解帧、超时重同步", "±180° 截断，20 ms"],
        ["telemetry.v", "34 字节遥测组帧、CRC16", "100 Hz，序号 + 时间戳"],
        ["uart_rx.v / uart_tx.v", "8N1 串口收发", "115200 bps"],
        ["key_filter.v", "按键消抖", "20 ms，三路例化"],
        ["PWM.v", "20 kHz、1% 步进 PWM", "周期 2500，步进 25"],
        ["pendulum.cst", "物理约束", "GW2A-LV18PG256CC8/I7"],
    ], [4.2, 6.4, 4.0], align_left_cols=(1, 2), font=9.5)

    h2(doc, "A.2 ESP32 固件文件")
    caption(doc, "表 A-2  ESP32 固件文件清单")
    table(doc, ["文件", "功能"], [
        ["boot.py", "按“抢连续内存”顺序初始化 UART、Wi-Fi、SPI、HTTP，再进入主程序"],
        ["tmp.py", "主循环、按键状态机、双界面切换与命令下发"],
        ["uart.py", "34 字节遥测解析（CRC 查表、只取最新帧）、5 字节命令组帧"],
        ["ui.py", "240×320 表盘与旋转角设置界面、指针缓冲、分区刷新"],
        ["web.py", "单连接非阻塞 HTTP 服务，GET /s?x= 下发角度"],
        ["wifi.py", "STA / AP 两种组网、掉线重连、状态查询"],
        ["board.py", "SPI 总线（20 MHz）提前创建，供显示模块复用"],
        ["st7789.py / vga1_16x32.py", "ST7789 驱动与 16×32 点阵字库"],
        ["www/index.html", "手机控制页（预设 0/90/180，±1/±10 微调，执行按钮）"],
    ], [4.6, 10.0], align_left_cols=(1,), font=9.5)

    h2(doc, "A.3 仿真用例与结果")
    caption(doc, "表 A-3  仿真用例与结论")
    table(doc, ["测试平台", "覆盖内容", "结果"], [
        ["tb_top_logic", "下垂计时、自动触发、捕获交接、K1 四种语义、超时", "8 项 PASS"],
        ["tb_swing_fast", "swing_up 模块 + 摆杆模型闭环", "0.575 s 捕获"],
        ["tb_uart_cmd", "数据字节含 AA/55/0D、超范围截断、正弦特殊帧", "9 项 PASS"],
        ["tb_ramp_move", "速度上限、无过冲、命令累加、行程限幅、跟踪保护", "全部 PASS"],
        ["tb_rotate / tb_rotate_top", "斜坡 + 正弦 + 目标装载", "全部 PASS"],
        ["tb_pid", "hold_int 清积分、D 对测量、启动无踢动", "4 项 PASS"],
        ["tb_top / tb_swing", "完整 top 闭环（50 MHz，长仿真）", "起摆后收敛"],
        ["model.py", "Python 控制律与 v_need 表生成", "1.02 s 到顶"],
    ], [4.4, 8.4, 3.6], align_left_cols=(1,), font=9.5)

    h2(doc, "A.4 已知问题与后续工作")
    para(doc, (
        "（1）角度标度需要统一。FPGA 端把命令帧的数值按“度”解析（1320 counts/圈），而 ESP32 端组帧时"
        "对设定角度做了 0.5 倍缩放，因此实际转角约为网页/按键设定值的一半。联调时应二选一：去掉 ESP32 "
        "侧的缩放，或在 FPGA 侧按 0.5° 单位换算，并把两边的换算关系写进协议文档。"
    ))
    para(doc, (
        "（2）时序未加约束。工程无 SDC，工具按默认 100 MHz 分析，最差路径（正弦/斜坡乘法链）Fmax "
        "约 14.4 MHz。当前依靠 1 ms 使能带来的超长稳定时间工作，建议补充 50 MHz 时钟约束并把乘法链"
        "流水化。"
    ))
    para(doc, (
        "（3）PWM 分辨率为 1%。小误差时控制量较粗，可把 PID 输出与 PWM 同步扩到 0.1%（输出 ±1000、"
        "比较值步进 2.5），在不引入死区的前提下改善低速平滑度。"
    ))
    para(doc, (
        "（4）命令无回执。当前协议只有单向命令，ESP32 无法确认“已执行/已到位”，只能看遥测里的 "
        "loc_error 与 flags 推断。后续可增加一帧短回执，或在遥测 flags 中增加“运动完成”位。"
    ))
    para(doc, (
        "（5）整机量化指标待补。表 1-1 与表 3-1 中标注“待整机复测”的项目（静态角度波动、抗扰恢复时间、"
        "连续运行时间、定位误差），需在标准测试条件下用 100 Hz 遥测记录后填入，避免评审追问时无法复现。"
    ))
    para(doc, (
        "（6）网络侧只有设计预算，缺少实测。表 2-6 中的 Wi-Fi 往返时延与端到端时延是按经验给出的假设值，"
        "尚未用遥测时标统计；断链保持与自动重连也只做了代码级验证。建议按 3.3.6 的三步法测一轮，并把"
        "丢帧率、时延分布（均值/95 分位）补进正文，网络控制的创新点才算有数据支撑。"
    ))

    doc.save(DST)
    print("saved", DST)


if __name__ == "__main__":
    build()
